NortonRicardo/filament-dryer/ESP32-NodeMCU-32S-38p-pinout.html

Placa do projeto

# NodeMCU ESP-32S

V1.1, header de 38 pinos. Ficha da placa e das ligações, conferidas no próprio hardware e no silkscreen.

Etapa 1A placa Etapa 2Display TFT Etapa 3Sensor BME280 Etapa 4Ventiladores Etapa 5Aquecedor

chip ESP32-D0WD-V3 revisão v3.0 núcleos 2 × 240 MHz flash 4 MB USB CP2102 MAC C8:F0:9E:52:EC:FC

## O que ela tem

## Pinagem

Placa vista por cima, com a antena no topo e o USB embaixo. São 19 pinos de cada lado: 32 GPIOs, três terras, 3V3, 5V e o EN. Dos 34 GPIOs do chip, só o 37 e o 38 não saem — esses dois nem existem no módulo WROOM.

Os rótulos são os que estão impressos na placa. O número entre parênteses é o GPIO que você escreve no código — e repare que os dois nem sempre batem.

## Monitor serial

O ESP32 não tem USB nativo: quem conversa com o computador é o CP2102 soldado na placa, visível na foto ao lado do conector. Ele aparece no Mac como /dev/cu.usbserial-0001. Todo Serial.println() do firmware sai por ali.

Configuração | Valor | Para quê
Velocidade | 115200 | Definida em monitor_speed. Precisa ser igual ao Serial.begin() do código, senão só aparece lixo na tela.
Porta | /dev/cu.usbserial-0001 | Detectada sozinha. Só aparece com a placa plugada.
Abrir o monitor | pio device monitor | Ou o ícone de tomada na barra do PlatformIO. Ctrl+C fecha.
Gravar e abrir junto | pio run -t upload -t monitor | Grava e já mostra o boot, sem perder as primeiras linhas.
Filtros | esp32_exception_decoder | Traduz travamento em número de linha do seu código, em vez de endereço de memória.
| time | Põe a hora na frente de cada linha, útil para medir intervalos.

### Bibliotecas e dependências

A Etapa 1 não precisa de nenhuma biblioteca de fora. Tudo que o firmware de diagnóstico usa já vem com o core Arduino do ESP32.

Dependência | Origem | Para quê
platform = espressif32 | PlatformIO | Compilador, esptool e o core do ESP32. Instala sozinho no primeiro build.
framework = arduino | PlatformIO | Core Arduino-ESP32 2.0.17, sobre o ESP-IDF v4.4.7.
Arduino.h | core | Serial, ESP.getFlashChipSize(), psramFound() e os apelidos de pino.
esp_system.h | core | Motivo do último boot, via esp_reset_reason().
esp_chip_info.h | core | Modelo, revisão, número de núcleos e quais rádios existem.
esp_mac.h | core | Os quatro endereços MAC derivados do eFuse.
esp_flash.h | core | JEDEC ID da flash, que identifica o fabricante.
esp_partition.h | core | Percorre a tabela de partições gravada na flash.
soc/soc_caps.h | core | Quantos UART, I2C, SPI, PWM e touch este SoC tem.

Onde está esse firmware

Em extras/diagnostico_placa.cpp. Fica fora de src/ de propósito: o PlatformIO não compila o que está lá, então ele não briga com o teste do display. Para rodar de novo, copie por cima de src/main.cpp.

Nada aparece no monitor?

Quase sempre é velocidade errada ou o monitor aberto em outro programa travando a porta. O firmware também espera 400 ms antes de imprimir, senão as primeiras linhas se perdem.

## Pino por pino

Na ordem física, de cima para baixo, com a placa vista por cima e o USB embaixo.

Pino | GPIO | Recursos | Observação

## Limitações da placa

## Memória e rádios

A coluna da direita diz de onde veio cada número, para você saber no que confiar.

Item | Valor | Detalhe | Fonte

## Divisão da flash

Tabela padrão de fábrica para 4 MB, que é a que o PlatformIO grava. Ainda não li a tabela desta placa: para isso é preciso gravar o firmware de diagnóstico nela.

Nome | Tipo | Endereço | Tamanho | Conteúdo

Chip, flash e MAC lidos desta placa em 02/11/2026 com esptool flash_id. Pinagem conferida no silkscreen da própria placa, frente e verso.

módulo 4.0" TFT SPI 480×320 V1.1 tela 4,0" · 320×480 interface SPI 4 fios header 14 pinos driver ST7796S ✓ touch sem o chip U2 · desligado biblioteca TFT_eSPI

## O display

O GMT024-10 de 2,4" saiu do projeto. No lugar dele entra um módulo vermelho de 4 polegadas, 320×480 pixels, com touch resistivo e slot de cartão SD. Continua sendo SPI de 4 fios no VSPI, então os GPIOs do display anterior servem sem mudança: só os fios trocam de lugar no header.

Só a imagem funciona: o touch deste módulo não tem como funcionar, porque ele veio sem o chip XPT2046 no lugar do U2. A ligação do touch fica documentada em Ligações do touch para quando chegar um módulo com o chip. O cartão SD fica de fora.

Driver: ST7796S, confirmado no hardware

A serigrafia diz só 4.0'' TFT SPI 480X320 V1.1. Esse módulo, com 14 pinos e slot SD, é o da família MSP4020/MSP4021, que usa o ST7796S. O firmware começou com ele, e a tela acendeu com o painel desenhado. Se um dia aparecer um módulo parecido que acenda branco ou embaralhado com a fiação certa, a outra opção para 480×320 SPI é o ILI9488: troque a linha em platformio.ini.

VCC nos 5 V, de novo

Na traseira, ao lado do VCC, há um regulador de 3 pernas (U1). É a mesma situação do display anterior: alimentado com 3,3 V, o regulador fica sem folga e a imagem pode tremer. Nos 5 V ele regula direito.

Deixe o J1 aberto

Nesta família de módulos, o jumper J1 ao lado do regulador serve para pular o regulador quando a alimentação já é de 3,3 V. Com 5 V no VCC e o J1 fechado, os 5 V chegariam direto ao painel. Confira na traseira se ele está sem solda.

Sinal continua em 3,3 V

O regulador alimenta o painel. Não converte nível de sinal. SCK, SDI, CS, DC/RS e RESET seguem em 3,3 V, que é o que o ESP32 entrega. Nunca ponha 5 V num pino de sinal.

## Ligações

Oito fios, dos quais cinco ocupam GPIO: os mesmos cinco do display anterior. Os pinos foram escolhidos longe dos de strapping, dos que emitem pulso no boot e dos seis reservados à flash, tudo que a Etapa 1 mapeou. Na figura, os fios estão na ordem do header do display, da esquerda para a direita: VCC primeiro, LED por último.

Pino da placa | Pino do display | Sinal | Observação

Os nomes deste header

A serigrafia usa SDI(MOSI) para os dados que entram no display, SDO(MISO) para os que saem, DC/RS para comando ou dado e RESET para o reset. Comparando com o display anterior: SDA virou SDI(MOSI), SCL virou SCK e RES virou RESET.

Luz de fundo no P17, com brilho

Este módulo tem pino de luz de fundo, o LED, e o anterior não tinha. Pela documentação do módulo ele comanda a luz e acende em nível alto. Ligado no P17, o firmware manda PWM de 5 kHz nele: o brilho vai de 5 a 100% pela página, fica salvo, e o botão de apagar a imagem apaga também a luz. No boot a luz só acende depois que o painel está desenhado.

Nada de MISO nesta etapa

O display só recebe dados, então SDO(MISO) fica sem ligar e TFT_MISO não é definido. O P19 fica reservado: é o MISO do VSPI, e o touch vai precisar dele.

O touch tem ligação própria

Os cinco pinos T_ vão para um chip separado, o XPT2046. A ligação dele está logo abaixo, em Ligações do touch.

O cartão SD tem pinos próprios

O slot usa os quatro furos SD_CS, SD_MOSI, SD_MISO e SD_SCK na borda de baixo da placa, separados do header de 14 pinos. Não são usados aqui.

## Ligações do touch

Este módulo veio sem o chip do touch

O U2, que deveria ser o XPT2046, está vazio: só as ilhas de solda. O diagnóstico confirmou: o chip não responde no SPI (8191 em todas as leituras) e o T_IRQ não reage ao toque. A ligação abaixo é a certa, conferida com o fórum e com outros projetos do mesmo display, e fica pronta para um módulo com o chip. O código do touch está guardado em extras/touch/, com um LEIAME de como religar.

O touch é resistivo e tem chip próprio, o XPT2046, já soldado no módulo. Ele recebe energia do mesmo VCC e GND do display, então não precisa de fio de alimentação a mais: são só os cinco pinos T_. Três deles dividem o barramento SPI com o display. Os outros dois são do touch.

Pino da placa | Pino do display | Sinal | Observação

Dois fios no mesmo pino

O P18 passa a ir para dois lugares, o SCK do display e o T_CLK do touch. O mesmo vale para o P23, que vai para o SDI(MOSI) e para o T_DIN. Na protoboard, os dois jumpers entram na mesma fileira do pino. Isso é normal no SPI: o clock e os dados chegam aos dois chips, e só responde quem está com o seu CS em nível baixo.

Os dois CS nunca ficam ativos juntos

O display usa o P13 e o touch o P16. A TFT_eSPI cuida da alternância: para ler o toque, ela solta o display, baixa o clock para uns 2,5 MHz (o XPT2046 não acompanha os 40 MHz do display) e depois volta.

SDO(MISO) do display continua solto

No P19 entra só o T_DO. Ligar também o SDO(MISO) do display não traz nada para o projeto, porque nada é lido da tela, e cria o risco de o controlador do display segurar a linha e estragar a leitura do toque. Sem ele, o P19 fica só para o touch.

T_IRQ é opcional

Ele vai a nível baixo enquanto alguém toca a tela. Com ele, o firmware só consulta o XPT2046 quando há toque, sem ficar perguntando o tempo todo pelo SPI. Vai no P4, que aceita pull-up interno (INPUT_PULLUP), e assim a linha não fica flutuando quando ninguém toca. Sem esse fio o touch funciona do mesmo jeito, só com consulta contínua.

O que muda no platformio.ini

Duas linhas: -DTFT_MISO=19 e -DTOUCH_CS=16. A TFT_eSPI só ativa as funções de touch com as duas definidas. O T_IRQ não entra aí: ele é lido direto pelo firmware, no P4.

Touch resistivo precisa de calibração

O XPT2046 entrega números crus, de 0 a 4095, que não batem com os pixels. Na primeira vez, a TFT_eSPI desenha setas nos cantos para tocar (calibrateTouch()) e devolve cinco números. Eles ficam guardados na memória do ESP32, e a calibração não se repete a cada boot.

## Dá para usar menos pinos

Dos oito fios, dois não disputam GPIO: VCC e GND. Sobram seis GPIOs: cinco do SPI e do controle, mais o P17 da luz de fundo. Dois deles são negociáveis.

Fio | Dá para economizar? | O que acontece
SCK | não | É o clock do barramento.
SDI(MOSI) | não | É por onde os pixels passam.
DC/RS | não | Diz se o byte é comando ou pixel. Sem ele o painel não entende nada.
RESET | sim, de graça | Ligue no EN da placa: o display reinicia junto com o ESP32, que é o que você quer. Use -DTFT_RST=-1.
CS | sim, com preço | Ligue no GND e use -DTFT_CS=-1. Só funciona enquanto o display for o único dispositivo no SPI. Com este módulo isso custa caro: o touch dele fica impossível.

A recomendação: 4 GPIOs

Ligue o RESET no EN e mantenha o CS num GPIO. Você economiza um pino sem perder nada, e o touch continua possível.

Nesta placa não falta pino

Com 32 GPIOs expostos, cinco para o display não apertam nada. E os sensores I2C usam P21 e P22, que é outro barramento: não competem com o display.

## Configuração do projeto

A TFT_eSPI é rápida mas exige saber os pinos em tempo de compilação. Dá para configurar sem editar nada dentro da biblioteca: é o que USER_SETUP_LOADED faz, passando tudo por build_flags.

platformio.ini copiar

[env:esp32doit-devkit-v1]
platform = espressif32
board = esp32doit-devkit-v1
framework = arduino

; Chip confirmado via esptool: ESP32-D0WD-V3 rev v3.0, dual core, flash 4MB.
monitor_speed = 115200
monitor_filters = esp32_exception_decoder, time

; Le o .env e vira -DWIFI_SSID / -DWIFI_PASSWORD. As credenciais ficam fora
; do repositorio; o modelo versionado e o .env.exemplo.
extra_scripts = pre:scripts/carrega_env.py

lib_deps =
  bodmer/TFT_eSPI@^2.5.43
  ; Puxa sozinha a Adafruit Unified Sensor e a Adafruit BusIO.
  adafruit/Adafruit BME280 Library@^2.2.4

; A TFT_eSPI e configurada por aqui, sem editar arquivos da biblioteca.
; USER_SETUP_LOADED desliga o User_Setup.h dela e faz valer o que esta abaixo.
build_flags =
  -DUSER_SETUP_LOADED=1

  ; --- driver do painel ---------------------------------------------------
  ; Modulo vermelho "4.0'' TFT SPI 480X320 V1.1", header de 14 pinos com
  ; touch resistivo e slot de cartao SD. E a familia MSP4020/MSP4021, que usa
  ; ST7796S. Se a tela acender branca ou embaralhada, comente a linha do
  ; ST7796 e descomente a do ILI9488, o outro controlador usado em 480x320.
  -DST7796_DRIVER=1
  ; -DILI9488_DRIVER=1

  ; Nativo do ST7796: 320 de largura por 480 de altura, em retrato.
  -DTFT_WIDTH=320
  -DTFT_HEIGHT=480

  ; --- inversao de cor ------------------------------------------------------
  ; O init do ST7796 na TFT_eSPI nao manda INVON (diferente do ST7789 do
  ; display anterior), entao este flag so deixa o INVOFF explicito.
  ; Se o preto sair branco, troque por -DTFT_INVERSION_ON=1.
  ; Se o vermelho e o azul sairem trocados, acrescente -DTFT_RGB_ORDER=TFT_RGB.
  -DTFT_INVERSION_OFF=1

  ; --- ligacao ao ESP32 ---------------------------------------------------
  ; Pinos escolhidos para nao cair em pino de strapping nem de boot. Os mesmos
  ; do display anterior: so os fios mudam de lugar no header.
  ; O SDO(MISO) do display nao e usado: nada e lido da tela. O LED da luz de
  ; fundo vai no GPIO17, com PWM feito no main.cpp (nao pela TFT_eSPI).
  ; Touch desligado: este modulo veio sem o chip XPT2046 (U2). O codigo do
  ; touch esta guardado em extras/touch/, com os flags que ele precisa.
  -DTFT_MOSI=23
  -DTFT_SCLK=18
  -DTFT_CS=13
  -DTFT_DC=27
  -DTFT_RST=26

  ; --- fontes embutidas ---------------------------------------------------
  -DLOAD_GLCD=1
  -DLOAD_FONT2=1
  -DLOAD_FONT4=1
  -DLOAD_FONT6=1
  -DLOAD_FONT7=1
  -DLOAD_GFXFF=1

  -DSPI_FREQUENCY=40000000

Por que ainda diz devkit-v1

O board descreve o chip e a flash, não o formato do header. A NodeMCU ESP-32S tem o mesmo ESP32-D0WD-V3 e os mesmos 4 MB, então o perfil serve e grava sem erro. Trocar para nodemcu-32s funciona igual.

Dependências

bodmer/TFT_eSPI@^2.5.43 desenha na tela usando o SPI por hardware e traz as fontes embutidas, incluindo a de sete segmentos do relógio. Baixa sozinha no primeiro build. A SPI já vem com o core.

## Código de teste

Põe Hello World na tela e um relógio que anda de segundo em segundo, contando desde o boot. O mesmo relógio sai no monitor serial, junto da memória livre, e o LED azul da placa pisca no mesmo ritmo. Se os três andarem juntos, a ligação está certa.

Mora em extras/, não em src/

O src/main.cpp já está na Etapa 3, mas com um display novo este teste volta a ser útil: é o jeito mais curto de provar fiação e driver. O arquivo fica guardado porque a PlatformIO compila tudo que está em src/ — dois setup() no mesmo binário não linkam. Para rodar de novo, copie sobre o src/main.cpp.

extras/teste_display.cpp copiar

// ---------------------------------------------------------------------------
// Etapa 2 - teste do display 4" SPI 480x320 (ST7796S, header de 14 pinos)
//
// Mostra "Hello World" e um relogio que anda de segundo em segundo, tanto na
// tela quanto no monitor serial. Serve para provar tres coisas de uma vez:
// a ligacao esta certa, o driver escolhido e o correto, e o ESP32 esta vivo.
//
// Ligacao (configurada em platformio.ini, nao aqui):
//   VCC       -> 5V          SCK       -> GPIO18      RESET -> GPIO26
//   GND       -> GND         SDI(MOSI) -> GPIO23      CS    -> GPIO13
//   LED       -> GPIO17 (luz de fundo, acesa em nivel alto)  DC/RS -> GPIO27
//
// SDO(MISO) e os cinco T_ do touch ficam sem ligar neste teste.
// ---------------------------------------------------------------------------

#include <Arduino.h>
#include <TFT_eSPI.h>

TFT_eSPI tft = TFT_eSPI();

// Qual driver foi compilado. Se a tela nao acender, troque em platformio.ini.
#if defined(ST7796_DRIVER)
static const char *DRIVER = "ST7796S";
#elif defined(ILI9488_DRIVER)
static const char *DRIVER = "ILI9488";
#else
static const char *DRIVER = "nao definido";
#endif

static const uint8_t LED_PLACA = 2;  // LED azul de bordo, prova de vida extra
static const uint8_t PIN_LUZ = 17;   // pino LED do display: sem nivel alto, tela escura

static uint32_t segundoAnterior = UINT32_MAX;
static int16_t  larguraRelogio = 0;   // para apagar o valor antigo sem piscar

// Converte segundos desde o boot em HH:MM:SS.
static void formataRelogio(uint32_t total, char *buf, size_t n) {
  snprintf(buf, n, "%02u:%02u:%02u",
           (unsigned)((total / 3600) % 100),
           (unsigned)((total / 60) % 60),
           (unsigned)(total % 60));
}

// Alturas calculadas a partir da altura real da tela, nao fixas, para o
// layout continuar centrado se a rotacao mudar (retrato 320x480 ou
// paisagem 480x320).
static int16_t yTitulo()  { return tft.height() * 22 / 100; }
static int16_t yLegenda() { return tft.height() * 40 / 100; }
static int16_t yRelogio() { return tft.height() * 52 / 100; }
static int16_t yRodape()  { return tft.height() - 28; }

// Desenha o que nao muda: moldura, titulo e rodape.
static void telaFixa() {
  tft.fillScreen(TFT_BLACK);
  tft.drawRoundRect(4, 4, tft.width() - 8, tft.height() - 8, 6, TFT_DARKGREY);

  tft.setTextDatum(MC_DATUM);

  tft.setTextColor(TFT_WHITE, TFT_BLACK);
  tft.drawString("Hello World", tft.width() / 2, yTitulo(), 4);

  tft.setTextColor(TFT_DARKGREY, TFT_BLACK);
  tft.drawString("ligado ha", tft.width() / 2, yLegenda(), 2);

  char rodape[64];
  snprintf(rodape, sizeof rodape, "%s  %dx%d  SPI %d MHz",
           DRIVER, tft.width(), tft.height(), SPI_FREQUENCY / 1000000);

  // Em retrato a tela e estreita: cai para a fonte menor se nao couber.
  const uint8_t fonte = tft.textWidth(rodape, 2) <= tft.width() - 16 ? 2 : 1;
  tft.drawString(rodape, tft.width() / 2, yRodape(), fonte);
}

// Redesenha so o relogio. O padding apaga o valor anterior, evitando piscada.
static void desenhaRelogio(const char *texto) {
  tft.setTextDatum(MC_DATUM);
  tft.setTextColor(TFT_ORANGE, TFT_BLACK);
  tft.setTextPadding(larguraRelogio);
  tft.drawString(texto, tft.width() / 2, yRelogio(), 7);
  tft.setTextPadding(0);
}

void setup() {
  Serial.begin(115200);
  pinMode(LED_PLACA, OUTPUT);
  pinMode(PIN_LUZ, OUTPUT);
  digitalWrite(PIN_LUZ, HIGH);  // luz de fundo no maximo, sem PWM neste teste
  delay(400);  // da tempo ao monitor serial de abrir

  Serial.println();
  Serial.println("==================================================");
  Serial.println("  Etapa 2 - teste do display 4\" SPI 480x320");
  Serial.println("==================================================");
  Serial.printf("Driver compilado : %s\n", DRIVER);
  Serial.printf("Barramento SPI   : %d MHz\n", SPI_FREQUENCY / 1000000);
  Serial.printf("Pinos            : SCK=%d MOSI=%d CS=%d DC=%d RST=%d\n",
                TFT_SCLK, TFT_MOSI, TFT_CS, TFT_DC, TFT_RST);

  tft.init();
  // 0 = retrato 320x480. Se a imagem sair de cabeca para baixo, troque por 2
  // (o mesmo retrato girado 180 graus). 1 e 3 sao as duas paisagens.
  tft.setRotation(0);

  Serial.printf("Resolucao em uso : %d x %d\n", tft.width(), tft.height());
  Serial.println("Hello World");
  Serial.println("--------------------------------------------------");
  Serial.println("Se a tela ficou branca ou embaralhada, troque o");
  Serial.println("driver em platformio.ini (ST7796 <-> ILI9488).");
  Serial.println("--------------------------------------------------");

  larguraRelogio = tft.textWidth("00:00:00", 7);
  telaFixa();
}

void loop() {
  const uint32_t segundos = millis() / 1000;

  if (segundos != segundoAnterior) {
    segundoAnterior = segundos;

    char relogio[16];
    formataRelogio(segundos, relogio, sizeof relogio);

    desenhaRelogio(relogio);
    digitalWrite(LED_PLACA, segundos % 2);  // pisca a cada segundo

    Serial.printf("[%s] rodando · heap livre %u bytes\n",
                  relogio, (unsigned)ESP.getFreeHeap());
  }

  delay(20);
}

## Como testar

1. Com a placa desligada, faça os oito fios.Confira duas vezes o VCC e o GND: é a única troca que estraga alguma coisa.
2. Grave e abra o monitor.pio run -t upload -t monitor faz as duas coisas numa tacada.
3. Olhe primeiro o monitor, não a tela.O cabeçalho sai mesmo com o display desligado. Se ele aparece e o relógio anda, o ESP32 está bem e o problema é só fiação ou driver.
4. Depois a tela.Esperado: moldura cinza, Hello World em branco, relógio laranja em sete segmentos andando de segundo em segundo.

Sintoma | Causa provável | O que fazer
Tela apagada, monitor rodando | Luz de fundo sem alimentação | Confira o LED no P17 e o brilho na página, e o VCC e o GND.
Luz acesa, tela branca | Mau contato no GND | Foi o que aconteceu aqui. Com o terra falhando, a luz de fundo ainda acende, mas os sinais do SPI ficam sem referência e o controlador não recebe nada. Firme o jumper do GND ou troque-o antes de mexer em driver.
Luz acesa, tela branca (GND firme) | Driver errado, ou RESET/DC/RS/CS trocados | Reconfira esses três fios. Se estiverem certos, troque para ILI9488_DRIVER.
Imagem embaralhada ou listrada | SPI rápido demais para o cabo | Baixe SPI_FREQUENCY para 27000000. Jumpers longos são a causa mais comum.
Imagem tremendo, piscando junto | Regulador do módulo sem folga | O VCC precisa estar no 5V, não no 3V3.
Fundo branco em vez de preto | Inversão do painel | Troque -DTFT_INVERSION_OFF=1 por -DTFT_INVERSION_ON=1.
Laranja sai azul, azul sai laranja | Ordem das cores (RGB ou BGR) | Acrescente -DTFT_RGB_ORDER=TFT_RGB.
Imagem espelhada ou deitada | Rotação | Troque o setRotation() entre 0 e 3. O layout foi feito para retrato (0 ou 2).
Monitor com lixo na tela | Velocidade diferente | monitor_speed e Serial.begin() precisam bater em 115200.

O que veio do display anterior

O GMT024-10 (ST7789V, 240×320) deixou duas lições que valem aqui. Primeira: o VCC vai nos 5 V, porque o regulador do módulo precisa de folga. Segunda: a inversão de cor fica explícita em platformio.ini. No ST7789 isso era obrigatório, porque o init da TFT_eSPI manda INVON sem condição. O init do ST7796 não manda, então aqui o -DTFT_INVERSION_OFF=1 só deixa claro o que está valendo.

Display trocado em 06/11/2026. Etapa fechada no hardware: com o GND firme, o ST7796S acendeu e desenhou o painel. Luz de fundo depois passou do 3V3 para o P17, com brilho ajustável.

sensor BME280 lê temperatura · umidade interface I²C endereço 0x76 ou 0x77 biblioteca Adafruit BME280

## O sensor

Um único chip da Bosch que entrega as duas grandezas que interessam aqui: temperatura e umidade relativa. Fala por I²C, que gasta só dois GPIOs e não disputa nada com o display — ele é SPI.

Grandeza | Faixa | Precisão típica | Resolução
Temperatura | −40 a +85 °C | ±1,0 °C | 0,01 °C
Umidade relativa | 0 a 100 % | ±3 % | 0,008 %

A umidade que importa é a absoluta

O sensor entrega umidade relativa: o quanto o ar está cheio em relação ao que ele aguenta naquela temperatura. E ar quente aguenta muito mais água — então só de aquecer a caixa a relativa despenca, sem uma gota ter saído.

Número real: 25 °C com 60% de UR contêm 13,8 g/m³ de água. Aqueça para 45 °C sem retirar nada e o sensor passa a marcar 21% — parece seco, e continuam os mesmos 13,8 g/m³ lá dentro. A umidade absoluta só cai quando a água realmente deixa a caixa, e é ela que diz se a secagem está funcionando.

O firmware calcula pela fórmula de Magnus, a mesma do DryFilaBox: 6,112 · e^(17,67·T/(T+243,5)) · UR · 2,1674 / (273,15+T). Conferida contra tabela: 20 °C e 50% dão 8,64 g/m³, contra 8,65 tabelado. Aparece na linha de baixo do cartão de umidade, no display.

Pressão desligada no sensor, não só na tela

O BME280 também mede pressão barométrica, e isso não tem uso numa estufa. Em vez de ler e descartar, o canal fica desligado na configuração: SAMPLING_NONE para pressão. Uma conversão a menos por leitura e um registrador a menos para buscar no barramento.

BME280 ou BMP280?

São quase gêmeos e o silkscreen às vezes não ajuda: o BMP280 não mede umidade. O jeito certo de saber é o chip ID — 0x60 é BME280, 0x58 é BMP280. O firmware lê esse registrador e avisa no monitor, em vez de deixar a umidade sair como valor inválido sem explicação.

Alimente com 3,3 V

Mesma lição do display, com final diferente: os módulos pequenos de 6 pinos normalmente não têm regulador, e o chip é 3,3 V. Procure um regulador de três pernas na traseira. Não achou? Use o 3V3. O sensor puxa microamperes, então aqui não há problema de folga.

## Ligações

Quatro fios, dos quais dois ocupam GPIO. Os escolhidos são P21 e P22, o par de I²C padrão do ESP32 — livres no boot e fora dos reservados à flash.

Pino da placa | Pino do módulo | Sinal | Observação

Se o módulo tiver 6 pinos

Além de VCC, GND, SCL e SDA, aparecem CSB e SDO. Para I²C, deixe os dois sem ligar: a placa já tem resistores que põem o CSB em alto (escolhendo I²C em vez de SPI) e o SDO num nível que define o endereço. SDO no terra dá 0x76; no 3,3 V dá 0x77. O firmware tenta os dois, então não precisa saber de antemão.

Resistores de pull-up

O I²C precisa de resistores puxando SDA e SCL para o 3,3 V. Praticamente todo módulo GY-BME280 já traz os dois na placa, e o ESP32 também liga os internos. Só vale conferir se o barramento não subir de jeito nenhum.

Dois barramentos, zero conflito

Display em SPI (P18, P23, P13, P27, P26), sensor em I²C (P21, P22). Protocolos e pinos diferentes, sem precisar coordenar acesso entre os dois nem compartilhar clock.

## Fortalecer o barramento: pull-ups de 4,7 kΩ

O log mostrou leituras corrompidas com o cartucho desligado: o barramento já estava no limite, e a corrente do aquecedor só o derrubava de vez. A causa é o cabo longo com pull-ups fracos.

Pull-up no barramento | Tempo de subida | Norma I2C (máx. 1 µs)
só o interno do ESP32 (~45 kΩ) | 8,4 µs | 8× fora
10 kΩ do módulo | 1,9 µs | fora
4,7 kΩ | 0,9 µs | dentro
4,7 kΩ + 10 kΩ do módulo em paralelo | 0,6 µs | dentro

Calculado com ~220 pF no barramento (cerca de 2 m de cabo mais as entradas).

1. Desligue tudo.Fonte fora da tomada.
2. Um 4,7 kΩ entre o P21 (SDA) e o 3V3.Na placa do ESP32, perto dos pinos. Resistor não tem polaridade.
3. Outro 4,7 kΩ entre o P22 (SCL) e o 3V3.Mesmo lado. Só um par no barramento inteiro — não ponha outro na ponta do sensor.
4. Confira com o multímetro, ainda desligado.Ohmímetro entre P21 e 3V3: entre 3 e 4,7 kΩ. Se o módulo já tiver 10 kΩ próprio, vai marcar ~3,2 kΩ — está certo, os dois ficam em paralelo.
5. Ligue e acompanhe o log por uma hora.A meta é zero descartes com o cartucho desligado. Depois repita com ele ligado.

Por que no lado do ESP32

Com um único par de pull-ups, a posição pouco muda o tempo de subida — o que importa é a resistência total contra a capacitância do cabo. Do lado do ESP32 fica mais fácil de soldar e de trocar depois.

Não use menos que 2,2 kΩ

Pull-up forte demais obriga os pinos a afundar mais corrente para fazer o nível baixo. 4,7 kΩ é o meio-termo: rápido o bastante para o cabo, leve para os pinos.

Se ainda sobrar algum descarte

Torça o fio do SDA com um fio de GND e o do SCL com outro GND, ao longo de todo o cabo. É o próximo degrau, depois dos pull-ups.

## Modo forçado, e por que isso importa

O BME280 sabe medir sozinho, continuamente. O firmware não usa esse modo — e essa é a decisão menos óbvia desta etapa.

Modo | Como funciona | Efeito na temperatura
NORMAL | Mede sem parar, no ritmo dele. | O próprio chip se aquece e empurra a leitura para cima alguns décimos de grau.
FORCED | Dorme. Mede uma vez quando mandam, volta a dormir. | Praticamente sem autoaquecimento. É o usado aqui.

Erro que não dá para corrigir depois

Autoaquecimento não é ruído — é desvio sistemático, sempre para cima. Não sai na média nem em filtro. Numa estufa de filamento, temperatura é justamente a grandeza que vai comandar o aquecedor: medir alguns décimos acima significa desligar antes da hora, sempre. Custa duas linhas de configuração evitar isso agora.

## Configuração do projeto

Uma linha nova em lib_deps. O sensor não precisa de build_flags como o display: os pinos de I²C são passados em tempo de execução, no Wire.begin().

platformio.ini copiar

[env:esp32doit-devkit-v1]
platform = espressif32
board = esp32doit-devkit-v1
framework = arduino

; Chip confirmado via esptool: ESP32-D0WD-V3 rev v3.0, dual core, flash 4MB.
monitor_speed = 115200
monitor_filters = esp32_exception_decoder, time

; Le o .env e vira -DWIFI_SSID / -DWIFI_PASSWORD. As credenciais ficam fora
; do repositorio; o modelo versionado e o .env.exemplo.
extra_scripts =
  pre:scripts/carrega_env.py
  post:scripts/senha_ota.py

lib_deps =
  bodmer/TFT_eSPI@^2.5.43
  ; Puxa sozinha a Adafruit Unified Sensor e a Adafruit BusIO.
  adafruit/Adafruit BME280 Library@^2.2.4

; A TFT_eSPI e configurada por aqui, sem editar arquivos da biblioteca.
; USER_SETUP_LOADED desliga o User_Setup.h dela e faz valer o que esta abaixo.
build_flags =
  -DUSER_SETUP_LOADED=1

  ; --- driver do painel ---------------------------------------------------
  ; Modulo vermelho "4.0'' TFT SPI 480X320 V1.1", header de 14 pinos com
  ; touch resistivo e slot de cartao SD. E a familia MSP4020/MSP4021, que usa
  ; ST7796S. Se a tela acender branca ou embaralhada, comente a linha do
  ; ST7796 e descomente a do ILI9488, o outro controlador usado em 480x320.
  -DST7796_DRIVER=1
  ; -DILI9488_DRIVER=1

  ; Nativo do ST7796: 320 de largura por 480 de altura, em retrato.
  -DTFT_WIDTH=320
  -DTFT_HEIGHT=480

  ; --- inversao de cor ------------------------------------------------------
  ; O init do ST7796 na TFT_eSPI nao manda INVON (diferente do ST7789 do
  ; display anterior), entao este flag so deixa o INVOFF explicito.
  ; Se o preto sair branco, troque por -DTFT_INVERSION_ON=1.
  ; Se o vermelho e o azul sairem trocados, acrescente -DTFT_RGB_ORDER=TFT_RGB.
  -DTFT_INVERSION_OFF=1

  ; --- ligacao ao ESP32 ---------------------------------------------------
  ; Pinos escolhidos para nao cair em pino de strapping nem de boot. Os mesmos
  ; do display anterior: so os fios mudam de lugar no header.
  ; O SDO(MISO) do display nao e usado: nada e lido da tela. O LED da luz de
  ; fundo vai no GPIO17, com PWM feito no main.cpp (nao pela TFT_eSPI).
  ; Touch desligado: este modulo veio sem o chip XPT2046 (U2). O codigo do
  ; touch esta guardado em extras/touch/, com os flags que ele precisa.
  -DTFT_MOSI=23
  -DTFT_SCLK=18
  -DTFT_CS=13
  -DTFT_DC=27
  -DTFT_RST=26

  ; --- fontes embutidas ---------------------------------------------------
  -DLOAD_GLCD=1
  -DLOAD_FONT2=1
  -DLOAD_FONT4=1
  -DLOAD_FONT6=1
  -DLOAD_FONT7=1
  -DLOAD_GFXFF=1

  -DSPI_FREQUENCY=40000000

; --- atualizacao pelo Wi-Fi ---------------------------------------------------
; Grava com a caixa fechada: pio run -e ota -t upload
; Precisa do firmware com OTA ja gravado uma vez pelo USB (ambiente acima), da
; placa ligada e na mesma rede. A senha vem do .env (scripts/senha_ota.py).
; Se estufa.local nao resolver, troque pelo IP que aparece no rodape do display.
[env:ota]
extends = env:esp32doit-devkit-v1
upload_protocol = espota
upload_port = estufa.local

Dependências

adafruit/Adafruit BME280 Library traz atrás de si a Adafruit Unified Sensor e a Adafruit BusIO, sem precisar declarar: a PlatformIO lê o library.json dela e baixa as duas. A Wire já vem com o core.

## Código

Cada grandeza ganha um anel: a barra enche da base esquerda, sobe pela esquerda, cruza o topo e desce pela direita — de um lado ao outro — e o valor fica em negrito no centro. O relógio e o LED piscando da etapa anterior saíram: eram prova de vida enquanto a tela não funcionava, e agora a própria leitura é a prova.

Decisão | Valor | Por quê
Negrito | FreeSansBold18pt | As fontes embutidas da TFT_eSPI não têm versão negrito. Essa é uma free font do Adafruit GFX, já disponível porque LOAD_GFXFF está ligado.
Abertura do arco | 270°, de 45° a 315° | Na TFT_eSPI o ângulo 0 fica às 6 horas e cresce no sentido horário, passando pelas 9. Começando em 45° a barra sai da base esquerda e termina na base direita, deixando a abertura embaixo — onde cabe o rótulo.
Escalas | 0–60 °C · 0–100 % | Fixas, não automáticas. Escala automática faria uma oscilação de décimo de grau encher meio anel e mudaria o significado da mesma barra a cada leitura — impossível comparar uma hora com a outra.
drawArc, não drawSmoothArc | pontas sem suavização | A própria biblioteca diz que as pontas sem anti-aliasing existem "para permitir mudança dinâmica de comprimento com junção limpa entre segmentos". Com as pontas suavizadas cada emenda deixaria costura visível.
Raio interno | 48 px, não 46 | O retângulo que o padding do valor apaga mede 78×42 px — medido nos glifos da fonte, não estimado — e o canto dele fica a 44,3 px do centro. Com raio 46 sobravam 1,7 px e o número encostava no anel.
Uma casa decimal | até 99,9 | A partir de 100 o valor perde a decimal (100, não 100.0). Assim o texto nunca passa de quatro dígitos e cabe dentro do anel sem reduzir a fonte.
Grau desenhado | dois círculos | Só o símbolo da grandeza aparece sob cada anel: °C e %. O grau não existe nas fontes da TFT_eSPI, que cobrem 0x20 a 0x7E — então é desenhado como dois círculos concêntricos, que é exatamente o que ele é, e assim acompanha a cor da série.

src/main.cpp copiar

// ---------------------------------------------------------------------------
// Estufa de filamento - painel THERMO
//
// Le o BME280 e mostra temperatura e umidade no display, no layout de
// cartoes. Os cartoes de ventilador e aquecedor mostram o que o controle
// decidiu (ver controle.h). Serve tambem uma pagina na rede local, que e por
// onde tudo se configura (ver servidor.h).
//
// Display: 4" TFT SPI 480x320 V1.1, ST7796S, header de 14 pinos.
// Ligacao (os pinos ficam em platformio.ini, nao aqui):
//   VCC       -> 5V          SCK       -> GPIO18      RESET -> GPIO26
//   GND       -> GND         SDI(MOSI) -> GPIO23      CS    -> GPIO13
//   LED       -> GPIO17                               DC/RS -> GPIO27
//
// Sao oito fios. O SDO(MISO) do display fica sem ligar: nada e lido da tela.
// O LED e o controle da luz de fundo (acende em nivel alto): com PWM nele, o
// brilho e ajustavel pelo painel web.
//
// Sem touch por enquanto: este modulo veio sem o chip XPT2046 (U2). O codigo
// do touch esta guardado em extras/touch/.
//
// Ligacao do BME280 (I2C, pinos declarados abaixo):
//   VIN -> 3V3        SCL -> GPIO22
//   GND -> GND        SDA -> GPIO21
//
// O display e SPI e o sensor e I2C: barramentos diferentes, sem disputa de
// pino e sem precisar coordenar acesso entre os dois.
// ---------------------------------------------------------------------------

#include <Arduino.h>
#include <esp_system.h>
#include <time.h>
#include <esp_task_wdt.h>
#include <TFT_eSPI.h>
#include <Wire.h>
#include <Adafruit_BME280.h>
#include <Preferences.h>

#include "aviso.h"
#include "controle.h"
#include "diario.h"
#include "registro.h"
#include "servidor.h"
#include "tela.h"

TFT_eSPI tft = TFT_eSPI();
Adafruit_BME280 bme;

// Qual driver de tela foi compilado. Se nao acender, troque em platformio.ini.
#if defined(ST7796_DRIVER)
static const char *DRIVER = "ST7796S";
#elif defined(ILI9488_DRIVER)
static const char *DRIVER = "ILI9488";
#else
static const char *DRIVER = "nao definido";
#endif

// O init do ST7796 nao inverte; o flag em platformio.ini so deixa explicito.
// Se o preto sair branco, e a inversao que precisa mudar.
#if defined(TFT_INVERSION_OFF)
static const char *INVERSAO = "desligada (INVOFF)";
#elif defined(TFT_INVERSION_ON)
static const char *INVERSAO = "ligada (INVON)";
#else
static const char *INVERSAO = "nao definida (padrao do driver)";
#endif

static const uint8_t PIN_SDA = 21;
static const uint8_t PIN_SCL = 22;

// O modulo responde em 0x76 ou 0x77, conforme o resistor de endereco da placa.
static const uint8_t ENDERECOS[] = {0x76, 0x77};

static const uint32_t INTERVALO_LEITURA = 2000;      // ms entre leituras

// Quanto tempo o cartucho fica desligado antes de cada leitura, para o
// barramento do sensor ficar quieto. Carga resistiva corta na hora; esta
// folga e para a fonte e a fiacao acomodarem. 20 ms a cada 2 s custam 1% da
// potencia - invisivel num bloco com inercia de minutos.
static const uint32_t SILENCIO_MS = 20;

// I2C a 20 kHz em vez dos 100 kHz padrao. O sensor fica a ~1 m da placa, e
// I2C foi feito para centimetros: cabo longo tem capacitancia, deixa as bordas
// do sinal moles e pega o ruido do cartucho chaveando 4,2 A. Mais devagar, o
// sinal tem tempo de assentar. Para uma leitura a cada 2 s sobra velocidade.
static const uint32_t I2C_FREQ = 20000;

// Leituras falhas seguidas antes de dar o sensor por perdido. Uma falha
// isolada (ruido, ou o sensor reiniciado por um tranco de tensao) nao deve
// derrubar a secagem; um sensor solto de verdade falha sempre e e pego em
// 3 x 2 s = 6 s.
static const uint8_t FALHAS_MAX = 5;

// Prazo do watchdog. Ver o comentario no fim do setup().
static const uint32_t WATCHDOG_S = 30;
static const uint32_t INTERVALO_RETENTATIVA = 5000;  // ms entre buscas do sensor

static bool     sensorOk = false;
static uint8_t  enderecoSensor = 0;
static uint32_t ultimaLeitura = 0;

// ---------------------------------------------------------------------------
// Sensor
// ---------------------------------------------------------------------------

// Traduz o chip ID lido do sensor. Serve para pegar o caso em que chegou um
// BMP280 no lugar do BME280: sao quase identicos, mas o BMP nao tem umidade.
static const char *nomeChip(uint8_t id) {
  switch (id) {
    case 0x60: return "BME280";
    case 0x58: return "BMP280 - NAO mede umidade";
    case 0x56:
    case 0x57: return "BMP280 (amostra de engenharia)";
    default:   return "desconhecido";
  }
}

// Lista quem responde no barramento. Se o sensor nao aparecer, isso separa
// "ligacao errada" de "endereco diferente do esperado".
static void varreI2C() {
  diario.println("Varredura I2C:");
  uint8_t achados = 0;

  for (uint8_t endereco = 1; endereco < 127; endereco++) {
    Wire.beginTransmission(endereco);
    if (Wire.endTransmission() == 0) {
      diario.printf("  0x%02X respondeu\n", endereco);
      achados++;
    }
  }

  if (achados == 0) {
    diario.println("  ninguem respondeu - confira SDA, SCL, GND e os 3V3");
  }
}

static bool iniciaSensor() {
  for (uint8_t endereco : ENDERECOS) {
    if (!bme.begin(endereco, &Wire)) continue;
    Wire.setClock(I2C_FREQ);  // a biblioteca pode reabrir o barramento

    enderecoSensor = endereco;

    // MODO FORCADO em vez de continuo: o sensor dorme entre as leituras e
    // nao se aquece. Em modo continuo o proprio chip esquenta e puxa a
    // temperatura para cima alguns decimos - erro que nao da para corrigir
    // depois, e justamente temperatura e o que mais importa aqui.
    bme.setSampling(Adafruit_BME280::MODE_FORCED,
                    Adafruit_BME280::SAMPLING_X1,   // temperatura
                    Adafruit_BME280::SAMPLING_NONE, // pressao: nao interessa
                    Adafruit_BME280::SAMPLING_X1,   // umidade
                    Adafruit_BME280::FILTER_OFF);
    return true;
  }
  return false;
}

// ---------------------------------------------------------------------------
// Umidade absoluta - quanta agua existe mesmo no ar, em gramas por metro
// cubico. Formula de Magnus, a mesma do projeto DryFilaBox do Marlon Nardi.
//
// Por que isso importa numa estufa, e muito:
//
//   A umidade RELATIVA diz o quanto o ar esta cheio em relacao ao que ele
//   AGUENTA naquela temperatura. E ar quente aguenta muito mais agua. Entao
//   so de aquecer a caixa a UR despenca, sem uma unica gota ter saido.
//
//   Exemplo real: 25 C com 60% de UR tem 13,8 g/m3 de agua. Aqueca para
//   45 C sem tirar nada e a UR marca 21% -- parece seco. Mas continuam os
//   mesmos 13,8 g/m3 ali dentro.
//
//   A umidade ABSOLUTA so cai quando a agua realmente deixa a caixa. E ela,
//   nao a relativa, que diz se a secagem esta funcionando.
//
// Conferida contra tabela: 20 C e 50% dao 8,64 g/m3 (tabela: 8,65).
static float umidadeAbsoluta(float tempC, float umidadeRel) {
  const float pressaoSat = 6.112f * expf((17.67f * tempC) / (tempC + 243.5f));
  return pressaoSat * umidadeRel * 2.1674f / (273.15f + tempC);
}

// ---------------------------------------------------------------------------
// Validacao da leitura
//
// Quando o cartucho chaveia 4,2 A, o degrau de corrente acopla no cabo do
// I2C e a transferencia se corrompe. O BME280 nao avisa: a biblioteca devolve
// os bytes que leu, e a compensacao do datasheet transforma lixo em numero.
//
// Os valores nao sao aleatorios, sao assinaturas do barramento:
//
//   registradores em 0xFFFFF (barramento devolvendo 0xFF) -> ~182 a 190 C
//   registradores em 0x00000 (barramento em curto)        -> ~-141 C
//
// E o 182 e o caso FELIZ: ele estoura o teto e a protecao corta. O -141
// seria o perigoso - o PID leria "fazendo muito frio" e mandaria 100% de
// potencia para sempre. Por isso a leitura e validada antes de qualquer
// coisa olhar para ela: controle, display e grafico so veem numero plausivel.
// ---------------------------------------------------------------------------

// Ultima leitura boa: a validacao compara contra ela, e o display repinta
// a partir dela ao religar.
static float ultimaTemp = 0, ultimaUmid = 0;
static bool temLeitura = false;

static const float TEMP_PLAUSIVEL_MIN = -10.0f;
static const float TEMP_PLAUSIVEL_MAX = 100.0f;

// O ar de uma caixa fechada nao muda tanto assim em 2 s, nem com o cartucho
// no maximo. Um salto maior que isso e ruido, nao temperatura.
static const float SALTO_MAX_C = 5.0f;

// Descartar nao vira falha aqui: leSensor devolve false e o loop ja trata
// isso com o seu proprio contador de falhas seguidas.

static uint8_t descartesSeguidos = 0;
static uint32_t descartesTotal = 0;

static bool leituraPlausivel(float t, float u) {
  if (isnan(t) || isnan(u)) return false;
  if (t < TEMP_PLAUSIVEL_MIN || t > TEMP_PLAUSIVEL_MAX) return false;
  if (u < 0.0f || u > 100.0f) return false;
  if (temLeitura && fabsf(t - ultimaTemp) > SALTO_MAX_C) return false;
  return true;
}

static bool leSensor(float &temperatura, float &umidade) {
  if (!bme.takeForcedMeasurement()) return false;

  temperatura = bme.readTemperature();
  umidade     = bme.readHumidity();

  if (leituraPlausivel(temperatura, umidade)) {
    if (descartesSeguidos > 0) {
      diario.printf("Sensor           : voltou ao normal apos %u leitura(s) descartada(s)\n",
                    descartesSeguidos);
    }
    descartesSeguidos = 0;
    return true;
  }

  descartesSeguidos++;
  descartesTotal++;
  diario.printf("Sensor           : leitura descartada (%.1f C, %.1f %%) - %u seguida(s), %lu no total\n",
                temperatura, umidade, descartesSeguidos,
                (unsigned long)descartesTotal);

  // Aguenta alguns glitches sem derrubar nada. Passando disso, e falha.
  return false;
}

uint32_t leiturasDescartadas() { return descartesTotal; }

// ---------------------------------------------------------------------------
// Desenho
//
// Regra em todo este bloco: escolher a fonte logo antes de cada desenho ou
// medicao. setTextFont() zera a free font e setFreeFont() a repoe, entao
// misturar as duas sem reescolher daria a fonte errada sem erro de compilacao.
// ---------------------------------------------------------------------------

// Desenha texto com espaco extra entre as letras - metade do visual deste
// layout vem dai, e a TFT_eSPI nao tem letter-spacing.
//
// Resolve de passagem dois caracteres que as fontes nao tem, por cobrirem so
// 0x20 a 0x7E: "·" vira um ponto desenhado e "Ø" vira um O cortado.
//
// Com medir=true nao desenha nada, so devolve a largura - e assim que se
// centraliza ou alinha a direita.
static int16_t textoEspacado(int16_t x, int16_t y, const char *texto,
                             int16_t espaco, uint16_t cor, uint16_t fundo,
                             bool medir = false) {
  const int16_t inicio = x;
  const int16_t altura = tft.fontHeight();
  bool primeiro = true;

  if (!medir) {
    tft.setTextDatum(ML_DATUM);
    tft.setTextColor(cor, fundo);
  }

  for (const uint8_t *p = (const uint8_t *)texto; *p; p++) {
    if (!primeiro) x += espaco;
    primeiro = false;

    if (p[0] == 0xC2 && p[1] == 0xB7) {  // "·"
      if (!medir) tft.fillCircle(x + 2, y, 2, cor);
      x += 5;
      p++;
      continue;
    }

    char letra[2] = {0, 0};
    bool cortado = false;

    if (p[0] == 0xC3 && p[1] == 0x98) {  // "Ø"
      letra[0] = 'O';
      cortado = true;
      p++;
    } else {
      letra[0] = (char)p[0];
    }

    const int16_t largura = tft.textWidth(letra);
    if (!medir) {
      tft.drawString(letra, x, y);
      if (cortado) {
        tft.drawLine(x + largura - 1, y - altura / 2 + 2,
                     x + 1, y + altura / 2 - 2, cor);
      }
    }
    x += largura;
  }

  return x - inicio;
}

static void textoCentrado(int16_t cx, int16_t y, const char *texto,
                          int16_t espaco, uint16_t cor, uint16_t fundo) {
  const int16_t largura = textoEspacado(0, 0, texto, espaco, cor, fundo, true);
  textoEspacado(cx - largura / 2, y, texto, espaco, cor, fundo);
}

// Posicoes dentro do cartao, relativas a altura dele: rotulo no alto,
// valor no meio, detalhe embaixo.
//
// A faixa reservada ao valor e o que se apaga a cada leitura. Apagar so ela,
// e nao o cartao inteiro, e o que evita piscar. Ela cobre a altura dos
// digitos da FreeSansBold24pt (~34 px) com folga, sem encostar no rotulo nem
// no detalhe.
static int16_t yRotulo(const Cartao &c)     { return c.y + 20; }
static int16_t yValor(const Cartao &c)      { return c.y + c.a / 2 + 4; }
static int16_t faixaTopo(const Cartao &c)   { return yValor(c) - 24; }
static int16_t faixaAltura(const Cartao &)  { return 48; }
static int16_t yDetalhe(const Cartao &c)    { return c.y + c.a - 18; }

// Unidade ao lado do numero, em fonte pequena e cinza. O grau nao existe na
// fonte, entao vai desenhado como dois circulos - que e o que ele e.
// Template porque desenha tanto na tela quanto no sprite: na TFT_eSPI so
// drawPixel e virtual, entao passar o sprite como TFT_eSPI& desenharia na
// tela.
template <typename Alvo>
static int16_t desenhaUnidade(Alvo &a, int16_t x, int16_t y, const Cartao &c,
                              bool medir) {
  int16_t largura = 0;

  if (c.grau) {
    if (!medir) {
      a.drawCircle(x + 3, y - 5, 3, MUDO);
      a.drawCircle(x + 3, y - 5, 2, MUDO);
    }
    x += 9;
    largura += 9;
  }

  a.setTextFont(2);
  largura += a.textWidth(c.unidade);
  if (!medir) {
    a.setTextDatum(ML_DATUM);
    a.setTextColor(MUDO, CARTAO);
    a.drawString(c.unidade, x, y);
  }
  return largura;
}

// O valor e montado num sprite fora da tela e empurrado de uma vez. Apagar a
// faixa direto na tela e redesenhar deixava um quadro em branco visivel - a
// piscada na troca de valor. Todos os cartoes tem a mesma largura, entao um
// sprite so serve para todos (~13 KB).
static TFT_eSprite faixa = TFT_eSprite(&tft);
static bool faixaOk = false;

// O que esta desenhado em cada cartao. Valor igual nao redesenha.
static char valorNaTela[N_CARTOES][12];
static bool dadoNaTela[N_CARTOES];

static void esqueceValor(uint8_t i) { valorNaTela[i][0] = '\0'; }

template <typename Alvo>
static void montaValor(Alvo &a, int16_t ox, int16_t oy, const Cartao &c,
                       const char *valor, bool temDado) {
  a.fillRect(ox, oy, c.l - 6, faixaAltura(c), CARTAO);

  a.setFreeFont(&FreeSansBold24pt7b);
  const int16_t larguraValor = a.textWidth(valor);
  const int16_t larguraUnidade = temDado ? desenhaUnidade(a, 0, 0, c, true) : 0;
  const int16_t total = larguraValor + (temDado ? 3 + larguraUnidade : 0);

  const int16_t x = ox + (c.l - 6) / 2 - total / 2;
  const int16_t y = oy + faixaAltura(c) / 2;

  // desenhaUnidade() trocou a fonte ao medir: reescolhe antes de desenhar.
  a.setFreeFont(&FreeSansBold24pt7b);
  a.setTextDatum(ML_DATUM);
  a.setTextColor(temDado ? c.cor : MUDO, CARTAO);
  a.drawString(valor, x, y);

  if (temDado) desenhaUnidade(a, x + larguraValor + 3, y, c, false);
}

// Numero grande mais a unidade, centrados juntos no cartao. Sem dado, "--"
// em cinza: o cartao existe no layout mas nao inventa leitura.
static void desenhaValor(uint8_t i, const char *valor, bool temDado) {
  if (dadoNaTela[i] == temDado && strcmp(valorNaTela[i], valor) == 0) return;
  snprintf(valorNaTela[i], sizeof valorNaTela[i], "%s", valor);
  dadoNaTela[i] = temDado;

  const Cartao &c = CARTOES[i];

  if (!faixaOk) {
    faixa.setColorDepth(16);
    faixaOk = faixa.createSprite(c.l - 6, faixaAltura(c)) != nullptr;
  }

  if (faixaOk) {
    montaValor(faixa, 0, 0, c, valor, temDado);
    faixa.pushSprite(c.x + 3, faixaTopo(c));
  } else {
    montaValor(tft, c.x + 3, faixaTopo(c), c, valor, temDado);  // sem memoria: pisca, mas funciona
  }
}

static void desenhaCartao(uint8_t i) {
  const Cartao &c = CARTOES[i];
  esqueceValor(i);

  tft.fillRoundRect(c.x, c.y, c.l, c.a, 9, CARTAO);
  tft.drawRoundRect(c.x, c.y, c.l, c.a, 9, BORDA);

  tft.setTextFont(1);
  textoCentrado(c.x + c.l / 2, yRotulo(c), c.rotulo, 2, MUDO, CARTAO);
  textoCentrado(c.x + c.l / 2, yDetalhe(c), c.detalhe, 1, MUDO, CARTAO);
}

static void telaFixa() {
  tft.fillScreen(FUNDO);
  for (uint8_t i = 0; i < N_CARTOES; i++) desenhaCartao(i);
}

// Uma casa decimal, menos a partir de 100: assim o texto nunca passa de
// quatro digitos e cabe na largura do cartao sem reduzir a fonte.
static void formataValor(float valor, char *buf, size_t n) {
  if (valor >= 100.0f || valor <= -100.0f) snprintf(buf, n, "%.0f", valor);
  else                                     snprintf(buf, n, "%.1f", valor);
}

// Com a imagem desligada pelo painel web, o loop continua lendo o sensor e
// rodando o controle, so nao desenha. Ao religar, tudo volta com os valores
// atuais.
static bool telaLigada = true;

// --- luz de fundo ---------------------------------------------------------------
// PWM no pino LED do display. Pela documentacao do modulo (lcdwiki MSP4021),
// esse pino comanda a luz e acende em nivel alto. O canal 2 do LEDC usa outro
// temporizador que os canais 0 e 1 dos ventiladores, entao a frequencia aqui
// nao interfere nos 25 kHz deles.
static const uint8_t  PIN_LUZ    = 17;
static const uint8_t  CANAL_LUZ  = 2;
static const uint32_t LUZ_FREQ   = 5000;  // bem acima do que o olho percebe
static const uint8_t  BRILHO_MIN = 5;     // abaixo disso a tela parece morta
static const uint8_t  BRILHO_PADRAO = 60;
static const char    *NVS_BRILHO = "brilho";

static uint8_t brilho = BRILHO_PADRAO;  // %, 5 a 100

// Com a imagem apagada pelo painel web a luz tambem apaga: tela preta com a
// luz acesa ainda brilha, e era isso que o modulo anterior obrigava.
static void aplicaLuz() {
  const uint8_t pct = telaLigada ? brilho : 0;
  ledcWrite(CANAL_LUZ, (uint32_t)pct * 255 / 100);
}

static void iniciaLuz() {
  ledcSetup(CANAL_LUZ, LUZ_FREQ, 8);
  ledcAttachPin(PIN_LUZ, CANAL_LUZ);
  ledcWrite(CANAL_LUZ, 0);  // apagada ate o painel estar desenhado

  Preferences nvs;
  if (nvs.begin("painel", true)) {
    if (nvs.isKey(NVS_BRILHO)) brilho = nvs.getUChar(NVS_BRILHO, BRILHO_PADRAO);
    nvs.end();
  }
  if (brilho < BRILHO_MIN || brilho > 100) brilho = BRILHO_PADRAO;
}

// --- temperatura maxima -------------------------------------------------------
// Definida no painel web e salva na memoria, entao sobrevive a um reinicio.
// Por enquanto so e guardada e mostrada: ainda nao entra na regra do controle.
static const char *NVS_PAINEL = "painel";
static const char *NVS_TMAX   = "tmax";
static const float TMAX_PADRAO = 30.0f;  // ate ser mudada no painel web

static float tempMaxima = 0;
static bool  temMaxima  = false;

// Sem valor salvo, parte de TMAX_PADRAO ja como configurada. O namespace
// "painel" pode nem existir no primeiro boot, e ai begin() em leitura falha:
// por isso o padrao e aplicado antes, nao depende do getFloat.
static void carregaMaxima() {
  tempMaxima = TMAX_PADRAO;
  temMaxima = true;

  Preferences nvs;
  if (nvs.begin(NVS_PAINEL, true)) {
    // isKey antes: getFloat de chave ausente imprime um erro no console.
    if (nvs.isKey(NVS_TMAX)) tempMaxima = nvs.getFloat(NVS_TMAX, TMAX_PADRAO);
    nvs.end();
  }
}

static void salvaMaxima(float valor) {
  tempMaxima = valor;
  temMaxima = true;

  Preferences nvs;
  nvs.begin(NVS_PAINEL, false);
  nvs.putFloat(NVS_TMAX, valor);
  nvs.end();

  diario.printf("Temp. maxima     : %.1f C (salva)\n", valor);
}

// Linha de baixo do cartao de temperatura. Em verde quando configurada, para
// distinguir de leitura; em cinza, "MAX --", quando ainda nao foi definida.
// Fonte 2, maior que a dos outros detalhes, porque e um valor que se
// consulta de longe.
static void pintaMaximo() {
  const Cartao &c = CARTOES[CARTAO_TEMP];
  char buf[20];

  tft.fillRect(c.x + 3, yDetalhe(c) - 9, c.l - 6, 18, CARTAO);
  tft.setTextFont(2);

  if (temMaxima) {
    snprintf(buf, sizeof buf, "MAX %.1f C", tempMaxima);
    textoCentrado(c.x + c.l / 2, yDetalhe(c), buf, 1, VERDE, CARTAO);
  } else {
    textoCentrado(c.x + c.l / 2, yDetalhe(c), "MAX --", 1, MUDO, CARTAO);
  }
}

// Temperatura, umidade relativa e umidade absoluta. A absoluta tem cartao
// proprio: e ela, e nao a relativa, que diz se a agua esta saindo da caixa.
// Sem leitura os tres mostram "--" em cinza, em vez de congelar o ultimo valor.
static void pintaMedidas() {
  char buf[16];

  if (!temLeitura) {
    desenhaValor(CARTAO_TEMP, "--", false);
    desenhaValor(CARTAO_UMID, "--", false);
    desenhaValor(CARTAO_UABS, "--", false);
    return;
  }

  formataValor(ultimaTemp, buf, sizeof buf);
  desenhaValor(CARTAO_TEMP, buf, true);

  formataValor(ultimaUmid, buf, sizeof buf);
  desenhaValor(CARTAO_UMID, buf, true);

  formataValor(umidadeAbsoluta(ultimaTemp, ultimaUmid), buf, sizeof buf);
  desenhaValor(CARTAO_UABS, buf, true);
}

static void mostraLeitura(float temperatura, float umidade) {
  ultimaTemp = temperatura;
  ultimaUmid = umidade;
  temLeitura = true;

  if (telaLigada) pintaMedidas();
}

static void mostraSemSensor() {
  temLeitura = false;
  if (telaLigada) pintaMedidas();
}

// Ventiladores e aquecedor, com o que o controle decidiu. O detalhe do cartao
// grande e reescrito junto, porque ele carrega o estado do aquecedor.
// Selo de estado na linha de baixo do cartao: borda arredondada com o texto
// dentro, so informativo. Verde ligado, vermelho desligado - o mesmo selo da
// pagina web.
static void desenhaSelo(uint8_t i, const char *texto, uint16_t cor) {
  const Cartao &c = CARTOES[i];
  const int16_t cy = yDetalhe(c);
  const int16_t a = 18;

  tft.fillRect(c.x + 3, cy - 10, c.l - 6, 20, CARTAO);
  tft.setTextFont(1);
  const int16_t lt = textoEspacado(0, 0, texto, 1, cor, CARTAO, true);
  const int16_t l = lt + 18;
  const int16_t x = c.x + c.l / 2 - l / 2;

  tft.drawRoundRect(x, cy - a / 2, l, a, a / 2, cor);
  textoEspacado(x + 9, cy, texto, 1, cor, CARTAO);
}

// Ventiladores e aquecedor, com o que o controle decidiu. No boot tudo esta
// desligado, e os tres cartoes mostram o selo vermelho ate o painel web ligar.
static void pintaControle() {
  char buf[16];

  for (uint8_t i = 0; i < 2; i++) {
    const uint8_t pct = controleVelocidade(i);
    const uint8_t cartao = CARTAO_FAN1 + i;
    snprintf(buf, sizeof buf, "%u", pct);
    desenhaValor(cartao, buf, pct > 0);
    desenhaSelo(cartao, pct > 0 ? "LIGADO" : "DESLIGADO",
                pct > 0 ? VERDE : VERMELHO);
  }

  snprintf(buf, sizeof buf, "%.0f", controleConfig().alvo);
  desenhaValor(CARTAO_HOTEND, buf, controleAquecedorLigado());

  // Ligado = liberado no painel, mesmo que agora esteja no alvo sem aquecer;
  // o numero fica laranja quando aquece de fato. Protecao aparece em vez de
  // DESLIGADO para a falha nao passar por desligamento normal.
  if (controleEstado() == EST_FALHA)  desenhaSelo(CARTAO_HOTEND, "PROTECAO", VERMELHO);
  else if (controleAutorizado())      desenhaSelo(CARTAO_HOTEND, "LIGADO", VERDE);
  else                                desenhaSelo(CARTAO_HOTEND, "DESLIGADO", VERMELHO);
}

// Rodape: so o endereco, centrado. Como ele vira "sem Wi-Fi" ou
// "conectando..." quando a rede cai, o estado da conexao continua visivel
// aqui sem precisar de um indicador separado.
static void desenhaRodape(const char *endereco) {
  // A faixa inteira do rodape, de borda a borda: a listra de aviso ocupa tudo,
  // e ao sumir ela precisa ser apagada tambem nas laterais.
  const int16_t topo = Y_RODAPE - ALTURA_RODAPE / 2;

  if (servidorPortalAtivo()) {
    // Sem a rede de casa: listra laranja com o nome e a senha da rede propria,
    // alternando com o aviso a cada 3 s (servidorEndereco()).
    tft.fillRect(0, topo, LARGURA, ALTURA_RODAPE, LARANJA);
    tft.setTextFont(2);
    textoCentrado(LARGURA / 2, Y_RODAPE, endereco, 1, FUNDO, LARANJA);
    return;
  }

  tft.fillRect(0, topo, LARGURA, ALTURA_RODAPE, FUNDO);
  tft.setTextFont(2);
  textoCentrado(LARGURA / 2, Y_RODAPE, endereco, 1, RODAPE, FUNDO);
}

// Relogio pequeno no canto direito do topo. Horas e minutos so: redesenha uma
// vez por minuto. "--:--" ate a hora chegar pela internet.
static char relogioNaTela[8] = "";

static void desenhaRelogio(bool forca) {
  char texto[8] = "--:--";
  if (horaCerta()) {
    const time_t agora = time(nullptr);
    struct tm t;
    localtime_r(&agora, &t);
    strftime(texto, sizeof texto, "%H:%M", &t);
  }
  if (!forca && strcmp(texto, relogioNaTela) == 0) return;
  snprintf(relogioNaTela, sizeof relogioNaTela, "%s", texto);

  tft.fillRect(LARGURA - MARGEM - 60, 0, 60, ALTURA_TOPO, FUNDO);
  tft.setTextFont(2);
  tft.setTextDatum(MR_DATUM);
  tft.setTextColor(MUDO, FUNDO);
  tft.drawString(texto, LARGURA - MARGEM, Y_TOPO);
}

// Painel inteiro: no boot e ao religar a imagem.
static void desenhaPainel() {
  telaFixa();
  desenhaRelogio(true);
  desenhaRodape(servidorEndereco());
  pintaControle();
  pintaMedidas();  // "--" ate a primeira leitura chegar
  pintaMaximo();
}

// --- chamadas do servidor -------------------------------------------------------

// Apagar e pintar de preto, nao mandar DISPOFF ao controlador: no ST7789 do
// display anterior o DISPOFF mostrava uma pagina branca, e pintar de preto da
// o resultado esperado em qualquer controlador, ao custo de redesenhar tudo
// ao religar. A luz de fundo continua acesa: o LED esta no 3V3.
void telaDefineLigada(bool ligada) {
  if (ligada == telaLigada) return;
  telaLigada = ligada;

  if (ligada) desenhaPainel();
  else        tft.fillScreen(TFT_BLACK);
  aplicaLuz();

  diario.printf("Tela             : %s\n", ligada ? "ligada" : "apagada");
}

bool telaEstaLigada() { return telaLigada; }

void telaDefineBrilho(uint8_t pct) {
  if (pct < BRILHO_MIN) pct = BRILHO_MIN;
  if (pct > 100) pct = 100;
  brilho = pct;
  aplicaLuz();

  Preferences nvs;
  nvs.begin("painel", false);
  nvs.putUChar(NVS_BRILHO, brilho);
  nvs.end();
}

uint8_t telaBrilho() { return brilho; }

// Tela de atualizacao: titulo e barra de progresso. Desenhada direto, sem os
// cartoes, porque durante a gravacao o loop nao roda e o painel ficaria
// congelado com valores velhos - e parecendo que o aquecedor ainda funciona.
void telaAtualizando(uint8_t pct) {
  static bool montada = false;
  const int16_t bx = 30, by = ALTURA / 2 + 10, bl = LARGURA - 60, ba = 18;

  if (pct == 0 || !montada) {
    montada = true;
    tft.fillScreen(FUNDO);
    tft.setTextDatum(MC_DATUM);
    tft.setTextColor(TEXTO, FUNDO);
    tft.drawString("ATUALIZANDO", LARGURA / 2, ALTURA / 2 - 40, 4);
    tft.setTextColor(MUDO, FUNDO);
    tft.drawString("aquecedor desligado - nao desligue a energia",
                   LARGURA / 2, ALTURA / 2 - 12, 2);
    tft.drawRoundRect(bx, by, bl, ba, 6, BORDA);
  }

  tft.fillRoundRect(bx + 2, by + 2, (bl - 4) * pct / 100, ba - 4, 4, CIANO);

  char buf[8];
  snprintf(buf, sizeof buf, "%u%%", pct);
  tft.setTextDatum(MC_DATUM);
  tft.setTextColor(TEXTO, FUNDO);
  tft.setTextPadding(60);
  tft.drawString(buf, LARGURA / 2, by + ba + 22, 4);
  tft.setTextPadding(0);

  if (!telaLigada) {          // imagem apagada pelo painel: mostra mesmo assim
    telaLigada = true;
    aplicaLuz();
  }
}

void telaFimAtualizacao() {
  desenhaPainel();
  aplicaLuz();
}

bool painelTempMaxima(float &valor) {
  valor = tempMaxima;
  return temMaxima;
}

void painelDefineTempMaxima(float valor) {
  salvaMaxima(valor);
  if (telaLigada) pintaMaximo();
}

// ---------------------------------------------------------------------------

// Por que a placa reiniciou. "WATCHDOG" significa que o loop travou e o chip
// se reiniciou sozinho - e o cartucho, por regra, voltou bloqueado.
static const char *motivoReinicio() {
  switch (esp_reset_reason()) {
    case ESP_RST_POWERON:  return "ligada na energia";
    case ESP_RST_SW:       return "por software (ex.: fim de atualizacao)";
    case ESP_RST_PANIC:    return "FALHA no firmware (excecao)";
    case ESP_RST_INT_WDT:
    case ESP_RST_TASK_WDT:
    case ESP_RST_WDT:      return "WATCHDOG - o loop travou e a placa se reiniciou";
    case ESP_RST_BROWNOUT: return "QUEDA DE TENSAO na alimentacao do ESP32";
    case ESP_RST_EXT:      return "botao EN";
    default:               return "outro";
  }
}

void setup() {
  Serial.begin(115200);
  delay(400);  // da tempo ao monitor serial de abrir

  // Antes da primeira linha do diario: assim o boot tambem fica gravado.
  registroInicia();

  diario.println();
  diario.println("==================================================");
  diario.println("  Estufa de filamento - painel THERMO");
  diario.println("==================================================");
  diario.printf("Reinicio         : %s\n", motivoReinicio());
  diario.printf("Registro         : %u de %u KB usados na flash\n",
                (unsigned)(registroUsado() / 1024),
                (unsigned)(registroTotal() / 1024));

  avisoInicia();
  diario.printf("Avisos           : %s\n",
                avisoLigado() ? "ligados (ntfy)" : "desligados - sem NTFY_TOPICO no .env");

  // Reinicio que nao foi por energia nem por atualizacao merece aviso: e o
  // tipo de coisa que acontece de madrugada sem ninguem ver. Fica na fila ate
  // o Wi-Fi subir.
  switch (esp_reset_reason()) {
    case ESP_RST_INT_WDT:
    case ESP_RST_TASK_WDT:
    case ESP_RST_WDT:
    case ESP_RST_BROWNOUT:
    case ESP_RST_PANIC:
      avisa("Estufa reiniciou", motivoReinicio(), 4);
      break;
    default:
      break;
  }
  diario.printf("Driver da tela   : %s\n", DRIVER);
  diario.printf("Inversao de cor  : %s\n", INVERSAO);
  diario.printf("Barramento SPI   : %d MHz\n", SPI_FREQUENCY / 1000000);
  diario.printf("Pinos da tela    : SCK=%d MOSI=%d CS=%d DC=%d RST=%d\n",
                TFT_SCLK, TFT_MOSI, TFT_CS, TFT_DC, TFT_RST);
  diario.printf("Pinos do sensor  : SDA=%d SCL=%d\n", PIN_SDA, PIN_SCL);

  controleInicia();
  servidorInicia();  // nao bloqueia: a rede sobe em paralelo ao resto
  carregaMaxima();
  diario.printf("Temp. maxima     : %.1f C\n", tempMaxima);

  Wire.begin(PIN_SDA, PIN_SCL);
  Wire.setClock(I2C_FREQ);
  diario.printf("I2C              : %lu kHz (cabo longo ate o sensor)\n",
                (unsigned long)(I2C_FREQ / 1000));
  varreI2C();

  sensorOk = iniciaSensor();
  if (sensorOk) {
    const uint8_t id = bme.sensorID();
    diario.printf("Sensor           : 0x%02X, chip ID 0x%02X (%s)\n",
                  enderecoSensor, id, nomeChip(id));
    if (id != 0x60) {
      diario.println("ATENCAO: nao e um BME280. A umidade vai sair invalida.");
    }
  } else {
    diario.println("Sensor           : NAO encontrado em 0x76 nem 0x77");
    diario.println("                   seguindo sem ele, tentando de novo a cada 5 s");
  }

  iniciaLuz();  // antes do init: a luz so acende com a imagem pronta
  tft.init();
  // 0 = retrato 320x480. Se a imagem sair de cabeca para baixo, troque por 2
  // (o mesmo retrato girado 180 graus). 1 e 3 sao as duas paisagens, mas o
  // layout de tela.h foi feito para retrato.
  tft.setRotation(0);

  diario.printf("Resolucao em uso : %d x %d\n", tft.width(), tft.height());
  diario.printf("Luz de fundo     : PWM no GPIO%u, brilho %u%%\n", PIN_LUZ, brilho);
  diario.println("--------------------------------------------------");

  desenhaPainel();
  aplicaLuz();

  // --- watchdog -------------------------------------------------------------
  // Se o loop() parar de girar por 5 s, o chip se reinicia sozinho. Sem isso,
  // um travamento com o cartucho a 100% o deixaria a 100% para sempre: todas
  // as protecoes (teto, sensor, "nao esquenta") sao software, e software
  // travado nao protege nada. Reiniciando, o GPIO25 solta, o 10 kOhm segura
  // o gate em zero e o firmware nasce com o aquecedor bloqueado.
  //
  // O core ja vem com o watchdog de tarefas em modo "reinicia" (PANIC=y) e
  // 5 s de prazo; enableLoopWDT() poe o loop() sob ele, e o proprio core o
  // alimenta a cada volta. So o OTA bloqueia mais que isso - ele alimenta
  // por conta propria (servidor.cpp).
  enableLoopWDT();
  // O prazo padrao do core e 5 s, e o WebServer espera ate 5 s por um cliente
  // lento (HTTP_MAX_DATA_WAIT) - um celular saindo do alcance no meio de um
  // pedido derrubaria a placa no meio da secagem. 30 s dao folga para isso e
  // para o OTA, e termicamente nao fazem diferenca: 30 s a mais de cartucho
  // num travamento real nao chegam perto do teto.
  esp_task_wdt_init(WATCHDOG_S, true);
  diario.printf("Watchdog         : ligado - loop travado por %u s reinicia a placa\n",
                WATCHDOG_S);
}

void loop() {
  const uint32_t agora = millis();

  servidorAtende();

  // A rampa do ventilador desce entre leituras, entao o controle roda no
  // ritmo do loop e nao no de 2 s do sensor.
  static uint8_t velAnterior[2] = {255, 255};
  controleTick();
  if (controleVelocidade(0) != velAnterior[0] ||
      controleVelocidade(1) != velAnterior[1]) {
    velAnterior[0] = controleVelocidade(0);
    velAnterior[1] = controleVelocidade(1);
    if (telaLigada) pintaControle();
  }

  // O endereco muda sozinho: conectando -> IP, ou IP -> reconectando. A tela
  // acompanha comparando o texto, para nao repintar a linha a cada volta.
  if (telaEstaLigada()) desenhaRelogio(false);

  int codigoAviso;
  if (avisoResultado(codigoAviso)) {
    if (codigoAviso == 200)
      diario.println("Aviso            : entregue ao celular");
    else
      diario.printf("Aviso            : FALHOU (codigo %d)\n", codigoAviso);
  }

  static bool avisouHora = false;
  if (!avisouHora && horaCerta()) {
    avisouHora = true;
    diario.println("Hora             : acertada pela internet (Brasilia)");
  }

  static char enderecoNaTela[40] = "";
  const char *endereco = servidorEndereco();
  if (strcmp(endereco, enderecoNaTela) != 0) {
    snprintf(enderecoNaTela, sizeof enderecoNaTela, "%s", endereco);
    // Com a tela apagada so guarda: ao religar, o rodape e redesenhado.
    if (telaLigada) desenhaRodape(endereco);
  }

  if (sensorOk) {
    if (agora - ultimaLeitura >= INTERVALO_LEITURA) {
      ultimaLeitura = agora;

      static uint8_t falhasSeguidas = 0;

      // Le com o cartucho desligado. Os 4,2 A corrompem o I2C deste cabo, e
      // nenhuma blindagem, capacitor ou separacao de terra resolveu. Em vez
      // de brigar com o acoplamento, a leitura acontece quando ele nao
      // existe. O PID nem fica sabendo: a potencia pedida nao muda.
      controleSilenciaSaida(true);
      delay(SILENCIO_MS);

      float temperatura, umidade;
      const bool leu = leSensor(temperatura, umidade);

      controleSilenciaSaida(false);

      if (leu) {
        if (falhasSeguidas > 0) {
          diario.printf("Sensor           : voltou a ler (%.1f C)\n", temperatura);
        }
        falhasSeguidas = 0;
        mostraLeitura(temperatura, umidade);
        registroMedida(temperatura, umidade);
        servidorRegistra(temperatura, umidade);
        controleNovaLeitura(true, temperatura);
        if (telaLigada) pintaControle();
      } else if (++falhasSeguidas < FALHAS_MAX) {
        // Falha isolada: ruido no cabo, ou o sensor se reiniciou num tranco
        // de tensao e perdeu a configuracao (volta sem medir umidade).
        // Reconfigura e tenta na proxima leitura. Ate la o controle segue
        // com a ultima potencia - sao 2 s.
        // Uma falha isolada e glitch de barramento: o sensor nao perdeu nada,
        // so a transferencia se corrompeu, e a proxima leitura vem boa.
        // Reconfigurar significa bme.begin(), que faz um reset no sensor e
        // espera a calibracao num laco SEM limite de tempo - com o barramento
        // devolvendo 0xFF ali, ele nunca sai. So vale a pena a partir da
        // segunda falha seguida, que ai o sensor pode ter reiniciado mesmo.
        if (falhasSeguidas >= 2) {
          diario.printf("Sensor           : leitura falhou (%u de %u), reconfigurando\n",
                        falhasSeguidas, FALHAS_MAX);
          iniciaSensor();
        } else {
          diario.printf("Sensor           : leitura falhou (%u de %u), tentando de novo\n",
                        falhasSeguidas, FALHAS_MAX);
        }
      } else {
        // Falhou FALHAS_MAX vezes seguidas: cabo solto, provavelmente. Volta
        // a procurar em vez de repetir o ultimo valor, que pareceria um
        // sensor travado.
        diario.printf("Sensor           : %u leituras falhas seguidas - perdido, voltando a procurar\n",
                      FALHAS_MAX);
        falhasSeguidas = 0;
        sensorOk = false;
        mostraSemSensor();
        servidorSemSensor();
        controleNovaLeitura(false, 0);
        if (telaLigada) pintaControle();
      }
    }
  } else if (agora - ultimaLeitura >= INTERVALO_RETENTATIVA) {
    ultimaLeitura = agora;

    if (iniciaSensor()) {
      sensorOk = true;
      diario.printf("Sensor apareceu em 0x%02X\n", enderecoSensor);
    }
  }

  delay(20);
}

Varredura de I²C no boot

Antes de tentar o sensor, o firmware pergunta a todos os 126 endereços quem responde e lista no monitor. Isso separa dois problemas que se parecem: ninguém respondeu é fiação ou alimentação; respondeu num endereço inesperado é só endereço.

Sem sensor não trava

Se o BME280 não aparece, as duas linhas mostram -- em vermelho e o firmware volta a procurar a cada 5 segundos. Fio solto no meio da execução também cai nesse caminho, em vez de congelar o último valor na tela — valor parado parece leitura válida, e isso enganaria.

Só o pedaço que mudou é repintado

O anel inteiro nunca é redesenhado. O firmware guarda quantos graus já estão pintados: se o valor sobe, desenha só o trecho que cresceu na cor da série; se cai, devolve o trecho que recuou para a cor da trilha. Repintar o anel todo apagaria e redesenharia a cada leitura, e isso pisca — o mesmo cuidado que resolveu o tremor na Etapa 2, por outro motivo.

Nada de sprite, e isso é economia

Um gráfico de linha precisaria de um buffer fora da tela para não piscar: 74 KB de heap. Desenhando o anel por segmentos o problema desaparece na origem, sem buffer nenhum. A RAM caiu de 7,4% para 6,8%.

## Como testar

1. Com a placa desligada, faça os quatro fios.VIN no 3V3, GND no GND, SDA no P21, SCL no P22.
2. Grave e abra o monitor.pio run -t upload -t monitor.
3. Leia a varredura de I²C primeiro.Esperado: uma linha 0x76 respondeu ou 0x77 respondeu. É o teste de fiação, antes de qualquer leitura.
4. Confira o chip ID.chip ID 0x60 (BME280) confirma que é o sensor com umidade.
5. Compare com o ambiente.Temperatura e umidade plausíveis para o seu quarto. Bafejar perto do sensor deve subir a umidade em segundos — é o teste mais rápido de que está medindo de verdade, e a barra do anel de umidade avança na hora.

Sintoma | Causa provável | O que fazer
Varredura vazia | Fiação, alimentação ou SDA/SCL trocados | Confira os quatro fios. Trocar SDA com SCL dá exatamente este sintoma.
Respondeu, mas não inicia | Endereço fora de 0x76/0x77 | Anote o endereço da varredura e acrescente à lista ENDERECOS.
chip ID 0x58 | É um BMP280 | Mede temperatura e pressão, mas não umidade. Precisa trocar o módulo.
Umidade sempre 0 ou 100 | BMP280 passando por BME280 | Mesmo caso acima; confirme pelo chip ID no monitor.
Temperatura uns graus acima | Calor da própria placa chegando ao sensor | Afaste o módulo do regulador e do ESP32. O modo forçado resolve o autoaquecimento do chip, não o do vizinho.
Valores saltando | Pull-up fraco ou fio longo | Encurte os fios do I²C; se persistir, 4,7 kΩ de SDA e SCL para o 3,3 V.

Compilado para este chip: 339 KB de flash (26% do slot) e 22 KB de RAM, sem buffer extra de heap. Falta a ligação física para fechar a etapa.

ventiladores 2 × 120 mm · 12 V fonte 12 V 5 A canais 2 independentes chave 2 × 2N2222 controle PWM 25 kHz

## Dois ventiladores iguais, dois canais separados

Os dois são de 12 V e 120 mm, os dois são chaveados, e cada um tem a sua própria velocidade. O cooler Intel de três fios saiu do projeto.

Ventilador | Onde fica | Trabalho | Faixa de uso
Cooler 1 | Perto do hotend, embaixo | Tira o calor do bloco e espalha pelo gabinete | Liga e desliga acompanhando o aquecedor
Cooler 2 | Mais acima, na lateral | Sopra para cima e põe o ar para circular | 70–80% em regime normal, 100% quando o hotend vai a plena carga

Nenhum ventilador em 3,3 V — nunca houve

Na versão anterior desta página havia um 10 kΩ → 3V3, e dá para ler como se um ventilador estivesse sendo alimentado ali. Não estava: aquilo era um pull-up no fio de rotação do cooler Intel, um fio de sinal que só informava se a hélice estava girando. Corrente de ventilador nunca passou por ali. Como o Intel saiu do projeto, o fio e o resistor saíram junto.

Duas velocidades exigem duas chaves

Um transistor é um interruptor: ele tem um estado só. Para o cooler 1 estar em 40% enquanto o cooler 2 está em 80%, são necessários dois canais — cada um com sua chave, seu resistor e seu diodo. Ligar os dois ventiladores na mesma chave faria os dois andarem sempre juntos, na mesma velocidade.

## O 2N2222 dá conta de 120 mm

O IRLB8721 está reservado ao cartucho aquecedor, que puxa 4 A e não aceita substituto. Para os ventiladores fica o 2N2222 — e em 120 mm ele é a peça certa, não um improviso. A faixa típica cai dentro do que ele satura.

Tamanho | Corrente típica a 12 V | 2N2222 dá conta?
80 mm | 100 – 200 mA | sim
120 mm | 150 – 350 mA | é o nosso caso
150 mm | 300 – 700 mA | pediria MOSFET

Com 150 Ω na base o pino entrega 17,3 mA, e isso satura o transistor com folga até 347 mA — que é justamente o topo da faixa de um 120 mm. Medir continua valendo, porque existe 120 mm de alta vazão que foge da faixa.

Corrente medida | Satura? | Calor a 100% | Veredito
200 mA | sim | 60 mW | tranquilo
300 mA | sim | 90 mW | tranquilo
350 mA | no limite | 140 mW | morno, aceitável
500 mA | não | 600 mW | só com PWM limitado
700 mA | não | 1400 mW | queima

Girar mais devagar ajuda, mas não resolve tudo

Essa foi a sua ideia, e ela está meio certa. O PWM corta o aquecimento médio: a 60% o transistor dissipa 60% do calor. Mas ele não reduz o pico de corrente — durante cada pulso ligado passa a corrente inteira do ventilador, e é esse pico que decide se o transistor satura ou não.

Traduzindo: a 500 mA, limitar o PWM a 60% derruba o calor de 600 mW para 360 mW e salva o transistor do forno. Mas ele continua sem saturar, ainda esquenta, e o ventilador recebe uns 10,8 V em vez de 12 V. Funciona; não é bonito.

Meça antes de ligar, não depois

Ligue um ventilador direto nos 12 V com o multímetro em série, escala de corrente contínua. O número que aparecer decide tudo. Dois minutos agora valem mais do que qualquer tabela minha.

Se o seu for de alta vazão e passar de 350 mA

Não precisa desistir: limite o PWM no firmware a 60% e acompanhe a temperatura do transistor na primeira hora. Se der para encostar o dedo e segurar, está dentro. Se queimar o dedo, a saída é um MOSFET de nível lógico — são baratos e qualquer IRLZ44N ou AO3400 serve. O IRLB8721 do aquecedor continua intocado.

São dois transistores

Um por canal. Dois 2N2222, dois resistores de base e dois diodos — os canais são independentes e nenhuma peça é compartilhada.

## Ligações

Os dois canais são idênticos. A chave nunca fica no lado positivo: os 12 V vão direto da fonte ao ventilador, e a chave abre e fecha o caminho de volta para o terra.

+12 V Terra comum Sinal do ESP32 Diodo de roda livre

De | Para | Observação
Cada ventilador · os dois são iguais
vermelho | +12 V | Direto da fonte. A chave nunca entra no lado positivo.
preto | coletor (C) | É o lado que o transistor liga e desliga do terra.
Cada 2N2222 · face chata para você, pernas para baixo: E · B · C
base (B) | P32 ou P33 por 150 Ω | Nunca direto no pino. Sem o resistor, a junção base-emissor é um curto e leva o GPIO junto.
base (B) | GND por 10 kΩ | Segura a base em zero enquanto o ESP32 inicia e os pinos ficam soltos.
coletor (C) | preto do ventilador | O ânodo do diodo também chega aqui.
emissor (E) | GND | O mesmo terra da fonte e do ESP32.
Um 1N4007 por ventilador · em paralelo com o ventilador, nunca no emissor
listra (cátodo) | +12 V | A listra prateada aponta para o positivo.
outro lado (ânodo) | coletor (C) | Invertido, fica em curto e queima na hora.

Terra comum: sem isso nada funciona

O GND da fonte de 12 V precisa estar ligado ao GND do ESP32. O transistor compara a tensão da base com a do emissor; sem terra comum não existe referência, e o ventilador liga sozinho ou não liga nunca. É o erro mais comum dessa montagem.

O resistor de 10 kΩ na base não é detalhe

Enquanto o ESP32 inicia, os pinos ficam em alta impedância por alguns milissegundos — soltos. Base solta capta ruído e o ventilador pode dar arrancos. O resistor de 10 kΩ entre base e GND segura a base em zero durante o boot, garantindo que os ventiladores só girem quando o firmware mandar.

Um diodo por ventilador

Ventilador é motor, motor é bobina. Quando a chave corta, o campo colapsa e a bobina devolve um pico invertido muito acima de 12 V. Sem o diodo esse pico cai em cima da chave e a mata. Os dois canais precisam do seu.

Cruzamento não é ligação

No desenho, fios ligados têm um ponto cheio. Onde as linhas apenas se cruzam — o diodo do canal 2 passando pelo fio do canal 1, e o terra do canal 1 passando pelo fio do canal 2 — não há contato.

## Qual perna é qual

O 2N2222 vem num corpo TO-92: uma face é chata e a outra é arredondada, igual a meia bolacha. É essa face chata que diz a ordem das pernas — e trocar duas delas é o erro mais rápido de cometer.

BC547 e 2N2222 são espelhados

Os dois são TO-92 e, por fora, idênticos. Mas com a face chata virada para você o 2N2222 é E·B·C e o BC547 é C·B·E — a ordem inverte. Se você tiver os dois na gaveta, leia o que está escrito no corpo antes de soldar. Montar um no lugar do outro põe os 12 V do ventilador direto no pino do ESP32.

Confirme com o multímetro, leva trinta segundos

Ponha o multímetro na escala de diodo. A base é a perna que, com a ponta vermelha nela, marca uns 0,7 V contra as duas outras. Depois, com a vermelha na base: a perna que marcar o valor ligeiramente maior é o emissor; a outra é o coletor. Funciona para qualquer NPN, de qualquer fabricante, e não depende de desenho nenhum.

No esquema acima

E vai no terra, B vai ao pino do ESP32 pelos 150 Ω, e C recebe o fio preto do ventilador. O vermelho do ventilador nunca encosta no transistor.

## Onde exatamente entra o diodo

Ele não é ligado "no transistor". Ele vai em paralelo com o ventilador — os dois lados do diodo pousam nos mesmos dois pontos em que o ventilador já está. Como um desses pontos é o coletor, na prática ele encosta no C. No E não encosta nunca.

A regra em uma frase

Os dois terminais do diodo ficam nos mesmos dois fios do ventilador: a listra junto do vermelho (que vem do +12 V), o outro lado junto do preto (que vai ao coletor). Se você conseguir encostar os dois lados do diodo nos dois terminais do próprio ventilador, está certo — não importa se é perto dele ou perto do transistor.

Por que não no emissor

O emissor está permanentemente no terra. Pôr o diodo entre o +12 V e o emissor seria ligar os 12 V direto no GND através dele — curto na fonte, e o diodo vira fumaça. O pico que precisa ser desviado aparece no coletor, que é o ponto que sobe de tensão quando o transistor corta.

Como achar a listra

O 1N4007 é um cilindro preto com uma faixa prateada ou cinza clara perto de uma das pontas. Essa ponta é o cátodo, e é ela que aponta para o +12 V. A outra ponta, sem marca, é o ânodo e desce para o coletor.

## A estratégia de controle

Como está no firmware. Ao ligar o ESP32, os dois ventiladores e o aquecedor começam desligados, e só a página liga.

Situação | Cooler 1 · hotend | Cooler 2 · circulação
Boot, nada ligado | 0% | 0%
Cooler 2 ligado, aquecedor desligado | 0% | mínima · padrão 70%
Aquecendo | 100% | máxima · padrão 100%
Acabou de desligar o aquecimento | 100% por 3 min, depois rampa de 2 min até parar | mínima

O cooler 1 desliga depois do aquecedor, não junto

O bloco do hotend continua quente depois que o cartucho desliga. Cortar o ventilador no mesmo instante deixa todo esse calor parado em cima do bloco. Por isso ele segue a 100% e depois desce em rampa. Os dois tempos se ajustam no modal do FAN 01, em minutos.

Já está no firmware

O cooler 1 é automático: segue o aquecedor e não tem botão próprio. O cooler 2 tem liga/desliga, máxima e mínima no modal do FAN 02, e nasce desligado a cada boot, como a autorização do aquecedor. No display e na página, cada cartão mostra um selo: DESLIGADO em vermelho, LIGADO em verde. O aquecedor é controlado por PID: os ventiladores tratam como "aquecendo" qualquer potência acima de 0%.

## PWM: 25 kHz, e nada abaixo de 30%

Frequência | O que acontece
100 Hz – 1 kHz | Dentro da faixa audível: o ventilador chia, porque a bobina vibra no ritmo do chaveamento. Numa estufa ligada por horas, incomoda.
25 kHz | Acima do que o ouvido capta. É a frequência que a indústria padronizou para ventilador.

Abaixo de uns 30% ele não parte

Ventilador sem escovas tem eletrônica própria por dentro, que precisa de tensão mínima para iniciar. Com PWM muito baixo ele fica zumbindo parado, sem girar — e parado ele esquenta. Na prática: ou está desligado, ou acima de uns 30%. Em 120 mm o efeito é mais forte, porque a hélice é pesada e custa mais a vencer a inércia. Descubra o mínimo real de cada um medindo, e trave esse valor no firmware.

## Quais pinos

Função | Pino | Por quê
PWM do cooler 1 | P32 | Livre, com saída, fora dos pinos de strapping e longe da flash.
PWM do cooler 2 | P33 | Mesma coisa. Os dois aceitam o LEDC, que é o gerador de PWM por hardware do ESP32.

O mapa até aqui

Display em P18, P23, P13, P27, P26, e a luz de fundo no P17. Sensor em P21 e P22. Ventiladores em P32 e P33. Aquecedor no P25. Onze dos 32 GPIOs ocupados. O P16 e o P19 ficam reservados para o touch.

## Como testar

1. Meça a corrente de um ventilador antes de tudo.Direto nos 12 V, multímetro em série. Abaixo de 350 mA o 2N2222 trabalha saturado; acima, limite o PWM e vigie a temperatura.
2. Monte um canal só, com a fonte desligada.Confira a listra do diodo e a ordem G·D·S antes de energizar. Não monte os dois de uma vez: se algo estiver errado, você queima duas peças em vez de uma.
3. Terra comum antes de energizar.GND da fonte ligado ao GND do ESP32, com tudo desligado. Só depois ligue os dois.
4. Teste sem PWM.Pino em nível alto fixo: gira a 100%. Em nível baixo: para por completo. Se não parar, a base não está sendo puxada para o terra.
5. Agora o PWM, descendo.Comece em 100% e vá baixando de 10 em 10. Anote onde ele para de girar — esse número vira o mínimo do firmware, e provavelmente não é igual nos dois.
6. Encoste na chave depois de um minuto a 100%.Morno é aceitável. Quente de não dar para segurar o dedo significa que ele não saturou — veja a tabela de corrente.
7. Só então monte o segundo canal.Repetindo os mesmos passos.

Sintoma | Causa provável | O que fazer
Gira sozinho ao ligar a placa | Falta o 10 kΩ da base ao GND | Acrescente. A base fica solta durante o boot.
Gira sozinho, sem comando nenhum | Terra não é comum | Ligue o GND da fonte ao GND do ESP32.
Nunca gira | E e C trocados | Face chata para você, pernas para baixo: E · B · C.
Gira devagar mesmo a 100% | Chave fora da saturação | Não saturou: resistor de base menor, ou corrente alta demais para ele.
Chia em velocidade média | PWM na faixa audível | Suba para 25 kHz.
Zumbe mas não gira | PWM abaixo do mínimo de partida | Suba o piso. Em 120 mm costuma ficar acima de 30%.
Chave queimou | Diodo ausente ou invertido | Listra no +12 V. Troque a chave junto.

Revisão desta etapa: os dois ventiladores passaram a ser 120 mm de 12 V, ambos chaveados e independentes. O cooler Intel de três fios e o pull-up de rotação saíram. Com 120 mm o 2N2222 trabalha saturado e sobra folga; o IRLB8721 fica reservado ao aquecedor.

carga cartucho 12 V · 50 W corrente ≈ 4,2 A chave IRLB8721 fusível 7,5 A firmware pronto · P25

## Por que aqui é MOSFET e não transistor

Um cartucho de 50 W a 12 V puxa 4,2 A. É dez vezes o que um ventilador de 120 mm pede, e trinta vezes o que um 2N2222 entrega bem. Não há discussão: o aquecedor é do MOSFET.

Chave | Perda a 4,2 A | Comentário
2N2222 | — | Nem chega lá: o máximo absoluto dele é 0,8 A.
IRLB8721 | ≈ 0,3 W | Resistência de uns 17 mΩ com 3,3 V no gate. Morno, sem dissipador.

Por que o IRLB8721 e não o IRLZ44N

O DryFilaBox do Marlon Nardi usa IRLZ44N, e funciona lá porque o Arduino entrega 5 V no gate — e ainda assim ele põe um 2N2222 como driver no meio do caminho. O ESP32 entrega 3,3 V. O IRLB8721 é especificado para conduzir bem nessa tensão; o IRLZ44N fica na fronteira. Com o 8721 dá para ligar o gate direto no pino, sem estágio intermediário.

## As peças, e o que cada uma faz

Lista tirada do projeto original, com a função de cada item.

Peça | Onde | Para quê
IRLB8721 | entre o cartucho e o terra | A chave. Lado baixo, como nos ventiladores.
Resistor 100 Ω | entre o GPIO e o gate | Limita o pico de corrente que carrega a capacitância do gate.
Resistor 10 kΩ | do gate ao GND | Segura o gate em zero durante o boot, quando os pinos ficam soltos.
Capacitor 470–1000 µF / 25 V | no 12 V, junto do MOSFET | Absorve o degrau de 4,2 A a cada chaveamento.
Capacitor 100–470 µF / 16 V + 100 nF | no 5 V, junto do ESP32 | Isola a placa dos solavancos da linha de potência.
Fusível 7,5 A | na linha do cartucho | Única proteção de hardware. Tudo o mais é firmware.
Fio 1 mm² | cartucho e 12 V | 4,2 A em fio fino aquece o fio, não a estufa.

Aqui NÃO vai diodo de roda livre

Essa foi a sua pergunta, e a resposta muda em relação aos ventiladores. O cartucho é um resistor: um fio de resistência enrolado num tubo. Não é bobina, não guarda campo magnético, não devolve pico nenhum quando a chave corta. O 1N4007 da lista do projeto original é descrito como "em paralelo com o cooler de 2 fios" — é do ventilador, não do aquecedor.

Os capacitores, sim, são obrigatórios

E são mais importantes aqui do que em qualquer outra etapa. Ligar e desligar 4,2 A cria um degrau que o fio da fonte não consegue acompanhar: a tensão afunda no instante em que o cartucho liga e salta quando desliga. Sem o eletrolítico junto do MOSFET, esse solavanco viaja pela alimentação e chega no ESP32 — que reinicia, ou lê o sensor errado. O de 100 nF cuida da parte rápida, que o eletrolítico é lento demais para pegar.

A aba metálica do MOSFET é o dreno

Ela está eletricamente ligada ao pino do meio. Se você parafusar o MOSFET num dissipador metálico sem isolador, o dissipador passa a estar no potencial do dreno. Use mica ou isolador plástico, ou deixe-o solto — a 0,3 W ele não precisa de dissipador.

## Ligação

+12 V Terra comum Sinal do ESP32 Filtro

Sem diodo, de propósito

Compare com a Etapa 4: lá cada ventilador tem o seu 1N4007. Aqui não há nenhum, e não é esquecimento — carga resistiva não devolve pico.

## Qual perna é qual

O IRLB8721 vem num corpo TO-220: uma placa preta com uma aba de metal furada em cima. Diferente do 2N2222, aqui não há face chata: quem diz a ordem é o lado escrito. Com ele virado para você e as pernas para baixo, a ordem é sempre a mesma.

Perna | Nome | Vai em
G esquerda | gate, o comando | Resistor de 100 Ω até o P25. O resistor de 10 kΩ sai daqui para o GND.
D meio | dreno, o lado da carga | Um fio do cartucho. O outro fio do cartucho vai ao +12 V, passando pelo fusível de 7,5 A. É o mesmo ponto da aba.
S direita | source, o terra | GND comum: o da fonte de 12 V e o do ESP32 juntos. Fio de 1 mm², porque os 4,2 A passam por aqui.

Dica de montagem: o 10 kΩ entre G e S

O resistor de 10 kΩ vai do gate ao GND, e o S já é o GND. Dá para soldá-lo direto entre as pernas G e S, por trás, pulando a do meio. Fica curto, sem fio solto, e o gate nunca fica no ar, nem com o fio do P25 desconectado.

Confirme com o multímetro

Escala de diodo. Ponta vermelha no S e preta no D: marca uns 0,4 a 0,7 V, que é o diodo interno do MOSFET. Invertendo as pontas, não marca nada. O G não conduz para nenhuma das outras duas, em nenhum sentido. E a aba dá continuidade com a perna do meio. Assim você confere o D, o S e o G sem depender de desenho.

A aba está no potencial do D

Se a aba encostar em metal ligado ao terra (gabinete, dissipador sem isolador), o cartucho liga direto e fica ligado, sem o firmware conseguir desligar. A 0,3 W ele não precisa de dissipador: deixe a aba livre, ou use mica e bucha isolante se for parafusar.

## Onde soldar os capacitores

O borne do hotend tem dois parafusos, e é aqui que a montagem engana: o parafuso que parece "negativo" não é o terra — ele é o D, que vai ao MOSFET. O capacitor precisa do +12 V e do GND de verdade.

Na prática

A perna + do eletrolítico e uma perna do 104 vão no parafuso do +12 V do borne. A perna − do eletrolítico e a outra perna do 104 vão no ponto de GND mais próximo da placa — não no outro parafuso do borne.

Por que entre os dois parafusos é ruim

Ali o capacitor fica em paralelo com o cartucho, não com a fonte. Quando o MOSFET liga, ele puxa o D para perto de zero e o capacitor carregado despeja tudo pelo canal de uma vez — um pico muito maior que os 4,2 A do cartucho. Faz o oposto do que se quer e maltrata o MOSFET a cada ciclo.

Os dois no mesmo par de pontos

Não é um no 12 V e outro no D: os dois ficam entre +12 V e GND, lado a lado. Eles cobrem tempos diferentes do mesmo transitório — o eletrolítico é grande e lento, o cerâmico é pequeno e rápido.

Pernas curtas importam

O que o capacitor combate é um degrau de 4,2 A em alguns microssegundos. Cada centímetro de perna é indutância em série, e indutância é exatamente o que atrapalha nessa escala. Corte as pernas no limite do que der para soldar.

## No firmware

Cartucho no P25

O gate do IRLB8721 vai no P25, com o resistor de 100 Ω em série e o de 10 kΩ do gate ao GND. Não é mais o GPIO2: aquele é pino de strapping, e com o MOSFET pendurado podia atrapalhar o boot. O LED azul de bordo deixou de ser o aquecedor.

PID com PWM lento

Como no Dry Fila Box do Marlon Nardi, a potência sai de um PID (0 a 100%) e chega ao cartucho por PWM. A diferença é a velocidade: lá o analogWrite chaveia a uns 490 Hz; aqui a janela é de 2 segundos — com 60%, o cartucho fica 1,2 s ligado e 0,8 s desligado. O bloco tem inércia de sobra, então o efeito térmico é o mesmo, com centenas de vezes menos chaveamento de 4,2 A. Os ganhos começam em Kp 10, Ki 0,03, Kd 0 (os do Marlon, 2/5/1, são os do exemplo da biblioteca) e se ajustam no modal do aquecedor. A potência aparece no estado: "AQUECENDO · 62 %".

As proteções que o firmware faz

Liga só pela página, e começa desligado a cada boot e depois de qualquer queda de energia. Corta e marca PROTEÇÃO em três casos: temperatura no teto de 60 °C, sensor sem leitura, ou 15 minutos com o PID no máximo sem a temperatura subir 1 °C. Esse tempo se ajusta de 5 a 60 minutos no modal do aquecedor, e não dá para desligar.

O que o firmware não vê

O BME280 mede o ar da caixa. Ninguém mede o bloco do cartucho. Se o cooler 1 parar ou o cartucho perder contato com o bloco, o metal esquenta muito antes de o ar perceber. Um fusível térmico preso ao bloco seria a proteção de hardware que falta, independente do firmware.

O IRLB8721 esquenta?

Pouco. A 4,2 A e com cerca de 17 mΩ de resistência com 3,3 V no gate, ele dissipa uns 0,3 W. Sem dissipador, isso sobe uns 20 °C acima do ambiente. Dentro da caixa a 55 °C ele fica perto de 75 °C, longe dos 175 °C que aguenta. O PWM do cartucho tem janela de 2 s: no máximo uma ligada e uma desligada por janela, então a perda de chaveamento é desprezível. Se ficar quente demais para encostar, o gate não está recebendo os 3,3 V inteiros: confira o resistor de 100 Ω e o fio do P25, e se a peça é mesmo um IRLB8721 (os IRF sem "L" precisam de 10 V no gate).

## Teste de fogo

1. Monte com tudo desligado da tomada.Confira o fusível de 7,5 A na linha do cartucho, os capacitores perto do MOSFET e do ESP32, o terra comum entre a fonte de 12 V e o ESP32, e que a aba do MOSFET não encosta em metal.
2. Ligue e olhe o monitor serial.Deve aparecer Cartucho : GPIO25 e Protecao : corta se 15 min ligado sem subir 1 C. O cartucho tem que estar frio: tudo nasce desligado.
3. Comece com o alvo baixo.Uns 40 °C no modal do aquecedor. Num modelo da caixa, os ganhos iniciais do PID chegam ao alvo passando cerca de 1,5 °C dele. Veja quanto passa na sua antes de subir para 55 °C: se passar muito ou ficar oscilando, baixe o Ki; se demorar demais ou estacionar abaixo, suba o Kp.
4. Ligue o FAN 02 e depois o aquecedor, pela página.O selo do aquecedor fica verde, o modal mostra "AQUECENDO · 100 %" no começo e a potência cai conforme chega ao alvo. O cooler 1 tem que ir a 100% junto. Confira com a mão, sem encostar no bloco, que ele está girando.
5. Fique do lado o tempo todo no primeiro teste.Com a fonte de 12 V ao alcance para desligar. Se o selo mostrar PROTEÇÃO, o modal do aquecedor diz o motivo.
