NortonRicardo/filament-dryer/ESP32-DevKit-V1-30p-pinout.html

Projeto em montagem

# ESP32 DevKit V1

Ficha da placa e das ligações, conferidas no próprio hardware.

Etapa 1A placa Etapa 2Display TFT

chip ESP32-D0WD-V3 revisão v3.0 núcleos 2 × 240 MHz flash 4 MB RAM 367 KB PSRAM nenhuma

## O que ela tem

## Pinagem

Placa vista por cima, com a antena no topo e o USB embaixo. Dos 34 GPIOs do chip, 25 saem no header; os GPIOs 6 a 11 ficam dedicados à flash e não aparecem.

A cor de cada pino indica o que limita o uso dele. O número entre parênteses é o GPIO que você escreve no código.

## Monitor serial

O ESP32 não tem USB nativo: quem conversa com o computador é o conversor serial soldado na placa, que aparece no Mac como /dev/cu.usbserial-…. Todo Serial.println() do firmware sai por ali, e foi assim que todos os números desta aba foram lidos.

Configuração | Valor | Para quê
Velocidade | 115200 | Definida em monitor_speed. Precisa ser igual ao Serial.begin() do código, senão só aparece lixo na tela.
Porta | /dev/cu.usbserial-… | Detectada sozinha. Só aparece com a placa plugada.
Abrir o monitor | pio device monitor | Ou o ícone de tomada na barra do PlatformIO. Ctrl+C fecha.
Gravar e abrir junto | pio run -t upload -t monitor | Grava e já mostra o boot, sem perder as primeiras linhas.
Filtros | esp32_exception_decoder | Traduz travamento em número de linha do seu código, em vez de endereço de memória.
| time | Põe a hora na frente de cada linha, útil para medir intervalos.

### Bibliotecas e dependências

A Etapa 1 não precisa de nenhuma biblioteca de fora. Tudo que o firmware de diagnóstico usa já vem junto com o core Arduino do ESP32.

Dependência | Origem | Para quê
platform = espressif32 | PlatformIO | Compilador, esptool e o core do ESP32. Instala sozinho no primeiro build.
framework = arduino | PlatformIO | Core Arduino-ESP32 2.0.17, sobre o ESP-IDF v4.4.7.
Arduino.h | core | Serial, ESP.getFlashChipSize(), psramFound() e os apelidos de pino.
esp_system.h | core | Motivo do último boot, via esp_reset_reason().
esp_chip_info.h | core | Modelo, revisão, número de núcleos e quais rádios existem.
esp_mac.h | core | Os quatro endereços MAC derivados do eFuse.
esp_flash.h | core | JEDEC ID da flash, que identifica o fabricante.
esp_partition.h | core | Percorre a tabela de partições gravada na flash.
soc/soc_caps.h | core | Quantos UART, I2C, SPI, PWM e touch este SoC tem.

Onde está esse firmware

Em extras/diagnostico_placa.cpp. Fica fora de src/ de propósito: o PlatformIO não compila o que está lá, então ele não briga com o teste do display. Para rodar de novo, copie por cima de src/main.cpp.

Nada aparece no monitor?

Quase sempre é velocidade errada ou o monitor aberto em outro programa travando a porta. O firmware também espera 400 ms antes de imprimir, senão as primeiras linhas se perdem.

## Pino por pino

Pino | GPIO | Recursos | Observação

## Limitações da placa

## Memória e rádios

Item | Valor | Detalhe

## Divisão da flash

Tabela de partições que veio gravada nos 4 MB.

Nome | Tipo | Endereço | Tamanho | Conteúdo

Dados lidos da placa em 02/11/2026 · ESP-IDF v4.4.7 · Arduino-ESP32 2.0.17 · MAC 70:B8:F6:5B:33:D0. Confira o silkscreen da sua placa: a ordem dos pinos varia entre fabricantes de clones.

módulo GMT024-10 v2.1 tela 2,4" · 240×320 interface SPI 4 fios driver ST7789V (a confirmar) biblioteca TFT_eSPI

## O display

Primeira peça a entrar no circuito. É um painel de 2,4 polegadas com 240×320 pixels e interface SPI de 4 fios, que o ESP32 toca por hardware pelo barramento VSPI.

Confira o silkscreen antes de ligar

Não achei a folha de dados do GMT024-10 v2.1 em nenhuma fonte. O que achei: na mesma família da GoldenMorning, o GMT024-08 é 2,4" 240×320 SPI com ST7789V e 8 pinos. Por isso o projeto começa com esse driver. Os nomes dos pinos abaixo são os usuais; compare um por um com o seu módulo.

Alimente com 3,3 V

O ESP32 fala em 3,3 V. Se o módulo não tiver regulador, 5 V no VCC pode queimar o painel. Comece pelo 3V3 da placa: se o módulo aceita os dois, 3,3 V funciona igual.

## Ligações

Oito fios. Os pinos do ESP32 foram escolhidos de propósito longe dos pinos de strapping e dos que emitem pulso no boot, tudo que a Etapa 1 mapeou.

Pino ESP32 | Pino do display | Sinal | Observação

Outros nomes para os mesmos pinos

Cada fabricante escreve diferente. SCL também aparece como SCK ou CLK; SDA como SDI, MOSI ou DIN; RES como RST ou RESET; DC como RS ou A0; BLK como LED ou BL.

Se o módulo tiver 14 pinos

Então é um ILI9341 com touch resistivo. Os cinco pinos T_ são o touch, num chip separado (XPT2046), e podem ficar desligados neste teste. Troque o driver em platformio.ini.

Nada de MISO neste teste

O display só recebe dados; não precisamos ler nada dele. Por isso TFT_MISO não é definido e o GPIO19 fica livre.

Luz de fundo no 3V3

O BLK fica aceso direto. Controlar o brilho por PWM puxa corrente demais para um GPIO: pede um transistor, e isso fica para depois.

## Configuração do projeto

A TFT_eSPI é rápida mas exige saber os pinos em tempo de compilação. Dá para configurar sem editar nada dentro da biblioteca: é o que USER_SETUP_LOADED faz, passando tudo por build_flags.

platformio.ini copiar

[env:esp32doit-devkit-v1]
platform = espressif32
board = esp32doit-devkit-v1
framework = arduino

monitor_speed = 115200
monitor_filters = esp32_exception_decoder, time

lib_deps =
  bodmer/TFT_eSPI@^2.5.43

build_flags =
  -DUSER_SETUP_LOADED=1

  ; driver do painel. Se a tela acender branca ou embaralhada,
  ; troque uma linha pela outra.
  -DST7789_DRIVER=1
  ; -DILI9341_DRIVER=1

  -DTFT_WIDTH=240
  -DTFT_HEIGHT=320

  ; ligacao ao ESP32
  -DTFT_MOSI=23
  -DTFT_SCLK=18
  -DTFT_CS=13
  -DTFT_DC=27
  -DTFT_RST=26

  ; fontes embutidas
  -DLOAD_GLCD=1
  -DLOAD_FONT2=1
  -DLOAD_FONT4=1
  -DLOAD_FONT6=1
  -DLOAD_FONT7=1
  -DLOAD_GFXFF=1

  -DSPI_FREQUENCY=40000000

Dependência | Versão | Para quê
bodmer/TFT_eSPI | ^2.5.43 | Desenha na tela usando o SPI por hardware do ESP32. Traz as fontes embutidas, incluindo a de sete segmentos do relógio. Baixa sozinha no primeiro build.
SPI | core | Vem com o core Arduino; a TFT_eSPI usa por baixo.

## Código de teste

Põe Hello World na tela e um relógio que anda de segundo em segundo, contando desde o boot. O mesmo relógio sai no monitor serial, junto da memória livre. Se os dois andarem juntos, a ligação está certa.

src/main.cpp copiar

// ---------------------------------------------------------------------------
// Etapa 2 - teste do display 2,4" SPI 240x320 (GMT024-10 v2.1)
//
// Mostra "Hello World" e um relogio que anda de segundo em segundo, tanto na
// tela quanto no monitor serial. Serve para provar tres coisas de uma vez:
// a ligacao esta certa, o driver escolhido e o correto, e o ESP32 esta vivo.
//
// Ligacao (configurada em platformio.ini, nao aqui):
//   VCC -> 3V3        SCL/SCK -> GPIO18        RES -> GPIO26
//   GND -> GND        SDA/MOSI -> GPIO23       CS  -> GPIO13
//   BLK -> 3V3                                 DC  -> GPIO27
// ---------------------------------------------------------------------------

#include <Arduino.h>
#include <TFT_eSPI.h>

TFT_eSPI tft = TFT_eSPI();

// Qual driver foi compilado. Se a tela nao acender, troque em platformio.ini.
#if defined(ST7789_DRIVER)
static const char *DRIVER = "ST7789V";
#elif defined(ILI9341_DRIVER)
static const char *DRIVER = "ILI9341";
#else
static const char *DRIVER = "nao definido";
#endif

static const uint8_t LED_PLACA = 2;  // LED azul de bordo, prova de vida extra

static uint32_t segundoAnterior = UINT32_MAX;
static int16_t  larguraRelogio = 0;   // para apagar o valor antigo sem piscar

// Converte segundos desde o boot em HH:MM:SS.
static void formataRelogio(uint32_t total, char *buf, size_t n) {
  snprintf(buf, n, "%02u:%02u:%02u",
           (unsigned)((total / 3600) % 100),
           (unsigned)((total / 60) % 60),
           (unsigned)(total % 60));
}

// Desenha o que nao muda: moldura, titulo e rodape.
static void telaFixa() {
  tft.fillScreen(TFT_BLACK);
  tft.drawRoundRect(4, 4, tft.width() - 8, tft.height() - 8, 6, TFT_DARKGREY);

  tft.setTextDatum(MC_DATUM);

  tft.setTextColor(TFT_WHITE, TFT_BLACK);
  tft.drawString("Hello World", tft.width() / 2, 52, 4);

  tft.setTextColor(TFT_DARKGREY, TFT_BLACK);
  tft.drawString("ligado ha", tft.width() / 2, 104, 2);

  char rodape[64];
  snprintf(rodape, sizeof rodape, "%s  %dx%d  SPI %d MHz",
           DRIVER, tft.width(), tft.height(), SPI_FREQUENCY / 1000000);
  tft.drawString(rodape, tft.width() / 2, tft.height() - 28, 2);
}

// Redesenha so o relogio. O padding apaga o valor anterior, evitando piscada.
static void desenhaRelogio(const char *texto) {
  tft.setTextDatum(MC_DATUM);
  tft.setTextColor(TFT_ORANGE, TFT_BLACK);
  tft.setTextPadding(larguraRelogio);
  tft.drawString(texto, tft.width() / 2, 150, 7);
  tft.setTextPadding(0);
}

void setup() {
  Serial.begin(115200);
  pinMode(LED_PLACA, OUTPUT);
  delay(400);  // da tempo ao monitor serial de abrir

  Serial.println();
  Serial.println("==================================================");
  Serial.println("  Etapa 2 - teste do display 2,4\" SPI 240x320");
  Serial.println("==================================================");
  Serial.printf("Driver compilado : %s\n", DRIVER);
  Serial.printf("Barramento SPI   : %d MHz\n", SPI_FREQUENCY / 1000000);
  Serial.printf("Pinos            : SCK=%d MOSI=%d CS=%d DC=%d RST=%d\n",
                TFT_SCLK, TFT_MOSI, TFT_CS, TFT_DC, TFT_RST);

  tft.init();
  tft.setRotation(1);  // paisagem: 320 x 240

  Serial.printf("Resolucao em uso : %d x %d\n", tft.width(), tft.height());
  Serial.println("Hello World");
  Serial.println("--------------------------------------------------");
  Serial.println("Se a tela ficou branca ou embaralhada, troque o");
  Serial.println("driver em platformio.ini (ST7789 <-> ILI9341).");
  Serial.println("--------------------------------------------------");

  larguraRelogio = tft.textWidth("00:00:00", 7);
  telaFixa();
}

void loop() {
  const uint32_t segundos = millis() / 1000;

  if (segundos != segundoAnterior) {
    segundoAnterior = segundos;

    char relogio[16];
    formataRelogio(segundos, relogio, sizeof relogio);

    desenhaRelogio(relogio);
    digitalWrite(LED_PLACA, segundos % 2);  // pisca a cada segundo

    Serial.printf("[%s] rodando · heap livre %u bytes\n",
                  relogio, (unsigned)ESP.getFreeHeap());
  }

  delay(20);
}

## Como testar

1. Com a placa desligada, faça os oito fios.Confira duas vezes o VCC e o GND: é a única troca que estraga alguma coisa.
2. Grave e abra o monitor.pio run -t upload -t monitor faz as duas coisas numa tacada.
3. Olhe primeiro o monitor, não a tela.O cabeçalho sai mesmo com o display desligado. Se ele aparece e o relógio anda, o ESP32 está bem e o problema é só fiação ou driver.
4. Depois a tela.Esperado: moldura cinza, Hello World em branco, relógio laranja em sete segmentos andando de segundo em segundo, e o LED azul da placa piscando no mesmo ritmo.

Sintoma | Causa provável | O que fazer
Tela apagada, monitor rodando | Luz de fundo sem alimentação | Confira o BLK no 3V3 e o VCC.
Tela branca acesa | Driver errado, ou RES/DC/CS trocados | Troque para ILI9341_DRIVER e reconfira esses três fios.
Imagem embaralhada ou listrada | SPI rápido demais para o cabo | Baixe SPI_FREQUENCY para 27000000.
Cores invertidas | Painel de fábrica com inversão | Acrescente -DTFT_INVERSION_ON=1.
Imagem espelhada ou deitada | Rotação | Troque o setRotation() entre 0 e 3.
Monitor com lixo na tela | Velocidade diferente | monitor_speed e Serial.begin() precisam bater em 115200.

Código já compilado para esta placa: 304 KB de flash (23% do slot) e 21 KB de RAM. Falta a ligação física para fechar o teste.
