NortonRicardo/filament-dryer/Caixa de circuito - estufa.3mf

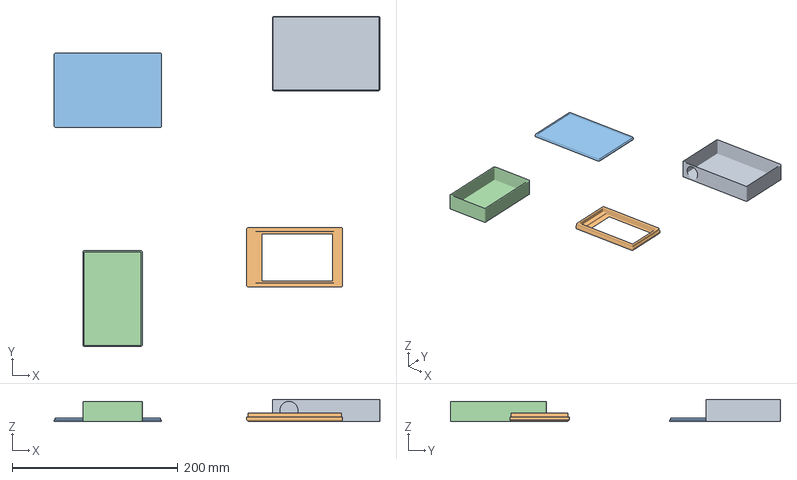
[picture p1: CAD file, 2026-11-09]
Caixa de circuito - estufa.3mf
393.8 x 398.8 x 27.0 mm
Corpo1
Corpo3
Corpo2
Corpo4
