NortonRicardo/filament-dryer/src/aviso.cpp

#include "aviso.h"

#include <HTTPClient.h>
#include <WiFi.h>
#include <WiFiClientSecure.h>

#ifdef NTFY_TOPICO

// Raizes de confianca do ntfy.sh: ISRG Root X1 e X2 (Let's Encrypt), tiradas
// do keychain do macOS e conferidas contra a cadeia servida pelo ntfy.sh. Hoje
// ele encadeia ate a X2; a X1 fica para o caso de a cadeia mudar. Validam ate
// 2035 e 2040.
static const char *RAIZES = R"PEM(
-----BEGIN CERTIFICATE-----
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
-----END CERTIFICATE-----
-----BEGIN CERTIFICATE-----
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
/q4AaOeMSQ+2b1tbFfLn
-----END CERTIFICATE-----
)PEM";

struct Aviso {
  char titulo[48];
  char texto[160];
  uint8_t prioridade;
};

static QueueHandle_t fila = nullptr;
static volatile int ultimoCodigo = 0;
static volatile bool resultadoNovo = false;

// Roda numa tarefa propria, no nucleo do Wi-Fi: um envio HTTPS leva de 1 a 3
// s (DNS, handshake TLS), e isso nao pode parar o loop que controla o
// cartucho. Avisos gerados sem rede ficam na fila ate ela voltar.
static void tarefa(void *) {
  Aviso a;
  for (;;) {
    if (xQueueReceive(fila, &a, portMAX_DELAY) != pdTRUE) continue;
    while (WiFi.status() != WL_CONNECTED) vTaskDelay(pdMS_TO_TICKS(5000));

    WiFiClientSecure cliente;
    cliente.setCACert(RAIZES);
    HTTPClient http;
    http.setTimeout(8000);

    int codigo = -1;
    if (http.begin(cliente, "https://ntfy.sh/" NTFY_TOPICO)) {
      http.addHeader("Title", a.titulo);
      http.addHeader("Priority", String(a.prioridade));
      http.addHeader("Tags", a.prioridade >= 5 ? "rotating_light" : "thermometer");
      codigo = http.POST((uint8_t *)a.texto, strlen(a.texto));
      http.end();
    }
    ultimoCodigo = codigo;
    resultadoNovo = true;
  }
}

void avisoInicia() {
  fila = xQueueCreate(6, sizeof(Aviso));
  xTaskCreatePinnedToCore(tarefa, "aviso", 10240, nullptr, 1, nullptr, 0);
}

bool avisoLigado() { return true; }

bool avisa(const char *titulo, const char *texto, uint8_t prioridade) {
  if (!fila) return false;
  Aviso a;
  snprintf(a.titulo, sizeof a.titulo, "%s", titulo);
  snprintf(a.texto, sizeof a.texto, "%s", texto);
  a.prioridade = prioridade;
  return xQueueSend(fila, &a, 0) == pdTRUE;  // fila cheia: descarta, nao trava
}

bool avisoResultado(int &codigo) {
  if (!resultadoNovo) return false;
  resultadoNovo = false;
  codigo = ultimoCodigo;
  return true;
}

#else  // sem NTFY_TOPICO no .env: avisos desligados, sem custo nenhum

void avisoInicia() {}
bool avisoLigado() { return false; }
bool avisa(const char *, const char *, uint8_t) { return false; }
bool avisoResultado(int &) { return false; }

#endif
