NortonRicardo/filament-dryer/(commit log)

2026-11-02 Identifica a placa e documenta a pinagem do ESP32
    Firmware de diagnostico que despeja no serial a identidade do chip,
    memoria, radios, perifericos, MACs e a tabela de particoes.
    A placa foi identificada como ESP32-D0WD-V3 revisao v3.0: dual core a
    240 MHz, 4 MB de flash externa em modo DIO, 367 KB de heap e sem PSRAM.
    Acrescenta esp32-pinout.html, um diagrama SVG interativo do header de
    30 pinos com as capacidades de cada GPIO (ADC1/ADC2, DAC, touch,
    strapping, somente entrada) e uma sugestao de ligacao para a estufa.
    Define monitor_speed em 115200 e habilita o decodificador de excecoes,
    que traduz travamentos em numeros de linha.
2026-11-03 Preserva o firmware de diagnostico em extras/
    O levantamento da placa (chip, revisao, flash, heap, particoes, MAC,
    radios) estava em src/main.cpp e seria perdido ao escrever o teste do
    display no lugar.
    Fica fora de src/ de proposito: a PlatformIO compila tudo que esta
    dentro de src/, e dois pares de setup()/loop() no mesmo binario nao
    linkam. Em extras/ o arquivo nao entra no build e continua a mao --
    para rodar de novo, basta copiar sobre src/main.cpp.
2026-11-03 Configura a TFT_eSPI e adiciona o teste do display 2,4" SPI
    Primeiro periferico do projeto: painel 240x320 (GMT024-10 v2.1).
    A biblioteca e configurada por build_flags com USER_SETUP_LOADED=1, que
    desliga o User_Setup.h dela. Assim a ligacao vive no platformio.ini e
    sobrevive a um `pio pkg update` -- editar arquivo dentro de .pio/libdeps
    seria perdido na primeira reinstalacao.
    Pinos escolhidos para nao colidir com pino de strapping (0, 2, 5, 12,
    15), com o pulso de boot (14) nem com a flash interna (6 a 11):
    SCK=18, MOSI=23, CS=13, DC=27, RST=26. O MISO fica sem definir porque
    o painel e somente escrita.
    O driver e uma aposta: paineis 2,4" dessa familia usam ST7789V ou
    ILI9341 e nao da pa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
2026-11-03 Transforma o documento da placa em abas e adiciona a Etapa 2
    A Etapa 1 continua igual: so caracteristicas da placa, sem nada de
    projeto. O que era pagina unica virou duas abas para o documento crescer
    por etapa em vez de inflar.
    Etapa 2 traz a ligacao do display 2,4" SPI e o codigo de teste. O codigo
    nao e copiado a mao: e injetado do src/main.cpp por script, para o
    documento nao poder divergir do que realmente compila.
2026-11-03 Renomeia o documento da placa incluindo o modelo
    A placa de desenvolvimento mudou, e vai existir mais de um documento de
    pinagem. "esp32-pinout.html" nao diz de qual placa fala.
    Conteudo intacto: este documento congela a DevKit V1 de 30 pinos, que
    sai do projeto aqui.
2026-11-03 Documenta a NodeMCU ESP-32S de 38 pinos, a placa do projeto
    Placa definitiva daqui para frente. Mesmo SoC da anterior
    (ESP32-D0WD-V3 rev v3.0, 4 MB de flash, sem PSRAM, conferido por
    esptool), mas 38 pinos em vez de 30 e conversor CP2102.
    Pinagem lida do silkscreen das fotos e conferida por contagem:
    19 + 19 pinos, 32 GPIOs sem duplicata, faltando so GPIO37 e 38 -- que
    realmente nao saem no modulo WROOM-32. Tres fontes independentes
    fechando e o que dispensa chute aqui.
    O risco novo da troca ganhou categoria propria em vermelho: CLK, SDO,
    SD1, SD2, SD3 e CMD sao os GPIOs 6 a 11, ligados a flash interna. Na de
    30 pinos eles nem saiam; aqui parecem livres e travam a placa. Marcados
    tambem SV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
2026-11-03 Preserva o teste do display em extras/
    Mesmo motivo do diagnostico da placa: o src/main.cpp segue para a etapa
    seguinte e este teste seria perdido. Fica fora de src/ porque a
    PlatformIO compila tudo que esta la dentro, e dois setup() no mesmo
    binario nao linkam.
    Ja cumpriu o papel -- confirmou ligacao, driver ST7789V e placa. Para
    rodar de novo, copiar sobre src/main.cpp.
2026-11-03 Le o BME280: temperatura, umidade e pressao
    Segundo periferico. Um unico chip da Bosch entrega as tres grandezas, por
    I2C em P21/P22 -- o display e SPI, entao nao ha disputa de pino nem
    clock compartilhado.
    MODO FORCADO em vez de continuo, e essa e a decisao que importa aqui. Em
    modo continuo o sensor mede sem parar, se aquece e empurra a temperatura
    alguns decimos para cima. Isso nao e ruido: e desvio sistematico, sempre
    na mesma direcao, que nao sai na media nem em filtro. Numa estufa a
    temperatura e quem vai comandar o aquecedor, entao medir alto significa
    desligar antes da hora, sempre. Custa duas linhas evitar.
    O endereco nao e fixo: o modulo responde em 0x76 ou 0x77 conforme o
    resist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
    [main.cpp]
2026-11-03 Documenta a Etapa 3 e corrige a Etapa 2 com o achado dos 5 V
    As duas mudancas ficam juntas porque sao o mesmo arquivo e a mesma
    sessao de bancada: ligar o display revelou um erro na Etapa 2 ao mesmo
    tempo que abriu a Etapa 3.
    Etapa 2, correcao: o documento mandava comecar com 3,3 V no VCC "por
    seguranca". Na traseira do modulo ha um regulador 6206-3.3 (XC6206, LDO
    de 3,3 V, ate 6 V na entrada), e com ele os 5 V sao a ligacao certa.
    Pior: com 3,3 V na entrada o regulador recebe exatamente o que deveria
    entregar, satura em ~3,0 V e para de regular, repassando ao painel toda
    oscilacao do trilho -- era a causa da imagem tremendo. Nos 5 V sumiu. O
    BLK fica nos 3V3, que e por fora do regulador. D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
2026-11-03 Desliga a inversao de cor do painel: o preto saia branco
    A tela acendia com fundo branco apesar de fillScreen(TFT_BLACK).
    A causa esta no codigo da TFT_eSPI, nao no hardware: a sequencia de init
    do ST7789 manda INVON sem condicao nenhuma (TFT_Drivers/ST7789_Init.h,
    linha 102). Depois dela, TFT_eSPI.cpp so aplica INVON ou INVOFF se um
    dos dois estiver definido. Sem nenhum, o painel fica invertido.
    A pegadinha: a maioria dos paineis IPS ST7789 precisa dessa inversao, e
    e por isso que ela vem ligada. Este painel nao precisa -- e nao basta
    deixar de ligar, e preciso desligar de forma explicita.
    Conferido no idedata que TFT_INVERSION_OFF=1 chega ao compilador, nao
    so que esta escrito no arquiv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
2026-11-03 Mostra temperatura e umidade em aneis, sem relogio nem LED
    A tela deixa de ser bancada de teste e passa a ser a interface do
    aparelho.
    Saiu o que era muleta de bring-up: o relogio contando desde o boot e o
    LED piscando. Os dois existiam para provar que a placa estava viva
    enquanto a tela nao funcionava; agora a propria leitura prova isso.
    Saiu tambem a pressao, e nao so da tela: o canal fica em SAMPLING_NONE
    no sensor, uma conversao a menos por leitura em vez de ler e descartar.
    Cada grandeza ganhou um anel com barra radial. Na TFT_eSPI o angulo 0
    fica as 6 horas e cresce no sentido horario, passando pelas 9: comecando
    em 45 e varrendo 270 graus, a barra sai da base esquerda, sobe, cruza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
2026-11-03 Passa o documento para fundo preto e registra a inversao
    Tema unico, sem seguir mais o do sistema: fundo, cartoes, tabelas,
    blocos de codigo e retangulos do SVG todos em #000000, texto em branco.
    Com o fundo todo preto as bordas passaram a ser a unica estrutura da
    pagina, e a que existia tinha contraste de 2,5:1 -- os cartoes
    desapareceriam. Clareada para 3,2:1. Todas as cores foram conferidas por
    calculo de contraste WCAG contra o preto, nao a olho: texto de 7,5:1
    para cima (minimo 4,5) e bordas acima de 3,0.
    Etapa 2 ganhou a nota sobre a inversao de cor, com a causa no codigo da
    biblioteca. A tabela de sintomas dizia "cores invertidas -> use
    TFT_INVERSION_ON", conselho incompleto que cus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
2026-11-06 Mantem as credenciais do Wi-Fi fora do repositorio
    O .gitignore foi escrito ANTES do .env existir, de proposito: assim a
    senha nunca passou por um estado em que o git pudesse enxerga-la.
    O .env vira -DWIFI_SSID e -DWIFI_PASSWORD por um extra_script, em vez de
    ficar no codigo ou no platformio.ini, que sao versionados. A conversao
    usa env.StringifyMacro da PlatformIO e isso nao e detalhe: a senha pode
    conter @, $ ou aspas, e montar a flag a mao quebraria no shell ou no
    pre-processador.
    Sem o .env o build para com instrucao em vez de erro de compilador.
    Conferido que nenhum arquivo versionado contem a senha. Ela existe em
    tres lugares no disco -- .env, .vscode/c_cpp_properties.json (gerado
    p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
2026-11-06 Serve as medicoes numa pagina na rede local
    O aparelho passa a ser acessivel pelo celular, sem cabo.
    A rede nao bloqueia nada: servidorInicia() volta na hora e a conexao
    sobe em paralelo. Se o Wi-Fi nao subir em 20 s, o firmware avisa uma vez
    e segue medindo e mostrando na tela. Termometro nao pode depender de
    roteador.
    Historico de 5 minutos em 150 amostras, 600 bytes de RAM. O JSON e
    montado a mao: sao poucos campos e dois vetores, e isso dispensa a
    ArduinoJson inteira.
    A pagina vive em PROGMEM -- flash, nao RAM -- e nao usa framework, CDN
    nem arquivo externo: um GET entrega tudo. As fontes sao as do sistema de
    proposito, porque o celular pode estar sem internet e uma fonte de CDN
    nao c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
2026-11-06 Redesenha o display no painel de cartoes
    A tela deixa de ser lista de valores e passa a ser o painel do aparelho:
    cinco cartoes, temperatura e umidade vivos, ventiladores e hotend em
    "--" ate o hardware existir. Nunca numero inventado.
    A paleta veio do mockup convertida para RGB565 por calculo, com o hex
    original no comentario de cada cor. Erro maximo de 5/255 num canal.
    Duas coisas que a biblioteca nao tem e foram resolvidas no desenho: o
    espacamento entre letras, que e metade do visual, e dois caracteres
    fora da faixa 0x20-0x7E -- o grau, desenhado como dois circulos, e o
    ponto do meio. O desenhador reconhece os bytes UTF-8 dos dois, entao o
    codigo-fonte fica legivel.
    Regra em todo o bl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
2026-11-06 Redesenha o documento e acrescenta a Etapa 4
    Visual: tipografia e espacamento no idioma da Apple, Inter sobre a pilha
    padrao do Tailwind, e o tema preto absoluto com superficies translucidas
    lido do DESIGN_SYSTEM.md da Climora -- inclusive a shadow-shape de la,
    copiada na integra e conferida por script.
    Duas licoes vieram daquele documento e corrigiram escolhas minhas:
    cartao e PRETO translucido (bg-black/80) e nao branco translucido; e
    texto e branco a 90%, nunca puro, porque puro "reduz o brilho excessivo
    num fundo totalmente preto". Sobre preto liso quem desenha o cartao sao
    os dois inset brancos da shadow-shape: o anel interno de 1px e o fio de
    luz no topo.
    Contraste conferido por calc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
2026-11-06 Guarda o documento de projeto do DryBox como referencia
    Nao foi escrito aqui: e o projeto original do usuario, usado como
    referencia de design e como fonte das decisoes de hardware que a
    Etapa 4 cita -- a divisao dos ventiladores, a fonte de 12 V, o
    IRLB8721 do aquecedor e a regra de o aquecedor nunca ligar sozinho.
    Fica versionado para as citacoes terem origem rastreavel.
2026-11-06 Troca o display pelo de 4" e passa toda a configuracao para a pagina web
    - Display novo: 4" ST7796S 320x480 (MSP4021), com seis cartoes em tres
    linhas: umidade relativa e absoluta, temperatura e aquecedor, FAN 01 e
    FAN 02. Rodape com o endereco do servidor.
    - Luz de fundo por PWM no GPIO17, com brilho ajustavel e salvo.
    - Temperatura maxima configuravel (padrao 30 C), mostrada em verde.
    - FAN 02 com liga/desliga, maxima com o aquecedor ligado e minima com ele
    desligado; fica ligado direto, sem depender da autorizacao.
    - Alvo padrao de 55 C (PETG), o maximo da caixa.
    - Pagina refeita para celular: configuracao em modais abertos pelos
    cartoes, botoes que mostram a acao, cursor no fim d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
2026-11-06 Comeca com ventiladores e aquecedor desligados a cada boot
    O liga/desliga do FAN 02 deixa de ser salvo e nasce desligado, pela mesma
    regra da autorizacao do aquecedor: so o painel web liga. O display mostra
    DESLIGADO/LIGADO na linha de baixo dos cartoes dos ventiladores e o estado
    do aquecedor passa de BLOQUEADO para DESLIGADO. Na pagina, o botao do
    aquecedor vira LIGAR/DESLIGAR.
2026-11-06 Mostra o estado de ventiladores e aquecedor em selos
    Selo informativo (borda e texto, nao e botao) na linha de baixo dos cartoes
    FAN 01, FAN 02 e Aquecedor, no display e na pagina: DESLIGADO em vermelho,
    LIGADO em verde, PROTECAO em vermelho quando a protecao do aquecedor
    dispara. O botao de ligar sai do cartao do aquecedor e fica so no modal.
2026-11-06 Controla o cartucho por PID com PWM lento no GPIO25
    O aquecedor sai do LED de bordo (GPIO2) para o gate do IRLB8721 no GPIO25.
    A potencia vem de um PID (0 a 100%, com anti-windup e derivada na medida)
    e chega ao cartucho por PWM em janela de 2 s, como no Dry Fila Box do Marlon
    Nardi, so que mais lento. Ganhos iniciais kp 10, ki 0,03, kd 0, ajustaveis
    no modal do aquecedor; a histerese sai.
    A guarda de "aquecendo sem subir" fica sempre ativa (5 a 60 min, padrao 15)
    e passa a valer para o PID no maximo, com referencia deslizante. Usa chave
    nova na memoria, porque a antiga estava gravada com 0 (desligada).
    Documento de pinagem: pernas do IRLB8721, luz de fundo no P17, touch sem o
    chip U2, reg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
2026-11-08 Documenta a gravacao pelo Wi-Fi num README
    Depois que a caixa fecha nao ha mais cabo USB, e toda atualizacao passa a
    ser pela rede. O procedimento estava espalhado entre o platformio.ini, o
    senha_ota.py e o servidor.cpp.
    Tres coisas que estavam implicitas no codigo e viraram texto:
    - a primeira gravacao tem que ser pelo cabo, porque o OTA so existe
    depois que um firmware que o contem ja esta rodando;
    - a senha do Wi-Fi e tambem a senha da atualizacao, entao trocar uma
    troca a outra;
    - o onStart retira a autorizacao antes do primeiro byte, ou seja, nao
    existe atualizar com o cartucho ligado.
    A tabela de problemas inclui o caso que custou tempo de verdade: duas
    interfaces de rede na m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
2026-11-08 Permite operar com a caixa fechada
    Duas metades do mesmo problema: fechada a caixa, o cabo USB sai, e com
    ele somem as duas coisas que a bancada dava de graca -- gravar firmware
    e ler o monitor serial. As duas voltam pela rede.
    GRAVAR PELO WI-FI. Ambiente "ota" separado, com espota em estufa.local.
    A separacao e proposital: sem -e os comandos continuam usando a USB, e
    ninguem grava pela rede por engano.
    A senha da atualizacao e a do Wi-Fi, lida do .env pelo senha_ota.py e
    entregue ao espota no momento do upload -- nunca no platformio.ini, que
    e versionado. O script roda como "post:" porque a plataforma monta os
    parametros do espota depois dos "pre:" e os substitui inteiros; um
    --auth posto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
    [controle.cpp, diario.cpp, diario.h, main.cpp, pagina.h, servidor.cpp]
2026-11-09 Torna o aparelho robusto para rodar sozinho
    Cinco mudancas que se cruzam nos mesmos arquivos (main.cpp e
    servidor.cpp), por isso juntas.
    LEITURA DO SENSOR. O BME280 nao tem checksum: quando a transferencia I2C
    se corrompe, a compensacao do datasheet transforma 0xFFFFF em ~182 C e
    0x00000 em ~-141 C - este ultimo faria o PID pedir 100% para sempre.
    - leitura validada antes de tudo (faixa -10 a 100 C, salto max. 5 C)
    - o cartucho e silenciado 20 ms durante cada leitura: os 4,2 A
    derrubavam o barramento, e nenhum capacitor ou separacao de terra
    resolveu. Custa 1% da potencia, invisivel no bloco
    - 5 falhas seguidas antes de declarar o sensor perdido (eram 3)
    - bme.begin() so a partir da 2a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
    [Caixa de circuito - estufa.3mf]
2026-11-09 Documenta pull-ups do I2C e onde soldar os capacitores
    Etapa 3: pull-ups de 4,7 kohm em SDA e SCL. Com os internos do ESP32
    (~45 kohm) e ~2 m de cabo o tempo de subida da 8,4 us, oito vezes acima
    do limite de 1 us do I2C; com 4,7 kohm, 0,9 us. Passo a passo, com
    desenho e a medicao para conferir antes de ligar.
    Etapa 5: os capacitores do cartucho vao entre +12 V e GND, nunca entre
    os dois parafusos do borne - o "negativo" do borne e o D do MOSFET, e
    ali o capacitor descarregaria pelo canal a cada acionamento. Desenho de
    certo e errado lado a lado.
    Codigo das etapas reinjetado dos arquivos reais.
2026-11-09 Avisa no celular e guarda log e historico na flash
    AVISOS PELO NTFY. Notificacao web pelo Safari exige HTTPS com certificado,
    e a pagina e http://estufa.local - o iPhone nao libera. O ntfy contorna:
    o celular assina um topico, a estufa publica nele com um POST HTTPS.
    - protecao disparada (urgente), com a ultima leitura e a potencia
    - todo boot, com o motivo e a data do firmware: ligada na energia,
    atualizada, reiniciada pelo botao, ou reinicio inesperado (watchdog,
    queda de tensao, falha) em prioridade alta
    - botao TESTAR AVISO no painel
    O envio roda numa tarefa propria no nucleo do Wi-Fi: um HTTPS leva de 1
    a 3 s e nao pode parar o controle do cartucho. Sem rede, espera na fila.
    TLS val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
2026-11-09 Le o sensor sem desligar o cartucho e so pausa quando precisa
    - Com o cartucho ligado e a caixa longe do teto, le a cada 10 s
    - Abaixo de 100%, le no trecho em que o PWM ja desligou o cartucho
    - A 100%, le com ele ligado e escala: pausa curta na 3a falha, longa
    (com reconfiguracao) da 4a em diante
    - Saltos de mais de 0,3 C so valem se a leitura seguinte confirmar
    - Filtro tambem barra salto de umidade (as leituras de 100%)
    - Grafico da web por tempo: um ponto a cada 15 s, 1 hora
2026-11-09 So desliga o cartucho na leitura depois de 4 falhas seguidas
    As quatro primeiras tentativas sao com o cartucho ligado; a quinta, com ele
    desligado. Sai a pausa curta.
2026-11-10 Le a cada ~1 min com o cartucho a 100%
    Com o I2C sem responder enquanto o cartucho esta ligado, cada ciclo de
    leitura acaba desligando-o uma vez. 50 s entre leituras dao ~1 desligamento
    por minuto. Vale so a 100%: abaixo disso o PID precisa de leituras
    frequentes, e elas ja caem no trecho desligado do PWM.
2026-11-10 Log com a linha mais nova no topo e botao de limpar o historico
    - /log le o arquivo de tras para frente, em blocos
    - LIMPAR HISTORICO no painel apaga as medidas gravadas (so por POST,
    com confirmacao); o log fica
2026-11-10 A 100% le uma vez por minuto com o cartucho desligado
    Sem tentar antes com ele ligado: com os 4,2 A passando o I2C nao responde.
    A folga antes da leitura cai de 20 para 5 ms, em teste.
2026-11-10 Botao de limpar o log no painel
    So por POST, com confirmacao; as medidas ficam.
2026-11-10 Escala do grafico da web acompanha os dados
    Temperatura e umidade vao do menor ao maior valor da ultima hora, com
    folga, em vez de 0-60 C e 0-100 %. A legenda mostra a faixa em uso.
